david20120720/motoko_after_math_linefollower/doc/ossconf_2015_paper/paper.pdf

OSSConf 2014: 1–6

REQUIRED VALUE CLASSIFICATION USING KOHONEN NEURAL NETWORK

MICHAL CHOVANEC

Abstract. In this paper we describe situations classification using Kohonen neural network. Results are demonstrated on line following robot, where different curves are classified. Each classificated situation has corresponding required value output, which is used by low level control process. Network weights estimates are processed in real time.

Key words and phrases. kohonen neural network, learning controll, iterative learning, PID controll, mobile robot.

Klasifikácia žiadanej hodnoty Kohonenovou neurónovou sieťou

Abstrakt. V článku je popísaná klasifikácia situacií Kohonenovou neurónovou sieťou. Výsledky sú demonštrované na robotovi, sledujúom čiaru, kde sú klasifikované rôzne typy zákrut. Každá situácia má zodpovedajúci výstup, ktorý je vstupom do nižšej úrovne riadenia.

Keywords. kohonenová neurónová sieť, inteligentné učenie, iteraivne učenie, PID riadenie, mobilný robot.

Introduction

It is well known that, iterative learning control can handle any repetitive control process [1], [2]. Most of applications we can found in manipulators control in industry.
Some problems have iterative (or semiterative) character, but more than one output sequence is required. Consider problem of line following robot. To control robot speed, it is necessary to know curve shape. If we can compute associative memory, where input is line shape and output is required speed, we can handle this problem.

### 1. Problem formalisation

Consider two wheels (two motors) robot with differential drive [3]. For motors control signals we can write

r(n) = v(n) − d(n),

l(n) = v(n) + d(n),

(1)

2 | Konferencia OSSConf 2014

where
r(n) (l(n)) is right (left) motor control output, v(n) is common control input, d(n) is difference control input.
The value of d(n) can be computed with sufficient precision using PD controller [5]. Our goal is to properly estimate d(n) which is speed of robot. Robot motion equations can be written as
θ(n) = (1 + α)θ(n − 1) − αθ(n − 2) + b0(r(n) − l(n))
ν(n) = αν(n − 1) + (1 − α)b1(r(n) + l(n)) | (2)

where
θ is robot orientation (Yaw angle), ν is robot speed, α is robot inertia constant, within (0, 1), b0 and b1 are constants dependent on wheel distances, wheel diameters, gear ratio, and maximum speed.
If required θ and ν are known, we can successfully use pure PID control defining error as eθ(n) = θr(n) − θ(n), eν(n) = νr(n) − ν(n), where θr(n) and νr(n) are required values. In our line following problem, νr(n) is unknown, value θ(n) is readed from line position sensor. In fact, inertia of motors is much smaller than inertia of whole robot, for control θ(n) we can still use PD controller. Let the required value be θr(n) = 0, which means robot is straight on line.
Our goal is to properly estimate v(n) and control robot speed, to give enough time for PD control to setup θ(n). We are minimizing eθ(n) and maximizing ν(n) (corespoding to v(n)).

### 2. Controller design

On figure 1 we can sse block diagram of proposed controller.

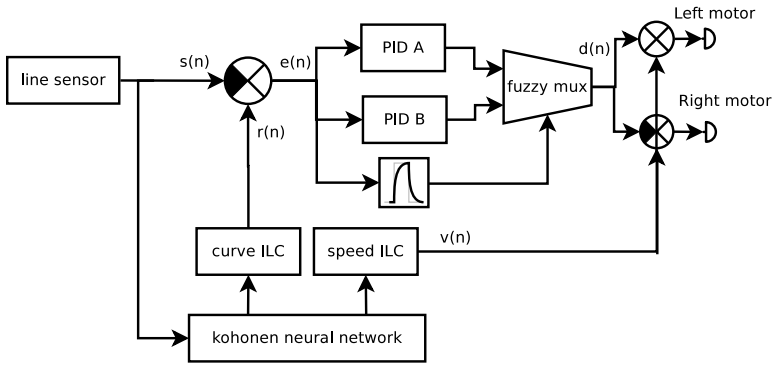
[picture p1: figure]

Figure 1. Robot controller.

Input is line position from sensor s(n). All values are normalised into h−1, 1i. Required value of θ(n) is marked as r(n). In simplificated case, it can be set to 0.

M. Chovanec: Required value classification using Kohonen neural network 3

Computed error is used as input into two PD controllers (PID in general, I-term is equal to zero, because 2 (θ part) has pole on 1 + 0i. If I-term is nonzero, there will be secondorder pole on 1 + 0i and system will be unstable).
PD controller outputs are mixed using fuzzy mux, which works as

d(n) = s

0
(n)a(n) + (1 − s

0
(n))b(n) | (3)

where
a(n) is PID A output, b(n) is PID B output, s

0
(n) is select input, from interval h0, 1i.

Select output is produced by nonlinear low pass filtered signal of e(n) as

s

0

(n) = (
s

0

(n − 1)k + (1 − k)|e(n)| for|e(n)| < s⁰ (n − 1),
|e(n)| | otherwise,

(4)

where k is filter constant, from (0, 1). This filter is smoothing error values. This system properly switches between two controllers, one for straight line and one for curved line.
To estimate v(n) we use Kohonen neural network [4] and iterative learning control. Neural network input is vector of s(n) values (implemented as FIFO, in experiments with size M = 16). Mark this vector as S(n) = [s(n), ..., s(n − M)]. Our goal, is to train network to make the classification of vectors S(n). Depending on count of classification classes, we choose corresponding neurons count
N. In experiments chooses we take N = 16 which means, 16 different curve shapes can be recognized.
Transfer function of j-th neuron can be written as

yj (n) =

M

X⁻¹

i=0

|s(n − i) − wj (i)| | (5)

where wj are neuron weights, initially chosen randomly and modified during learning process.
Neuron with smaller yq(n) will be marked as winning neuron, and weights modification will be done by formulae
wq(n) = ηwq(n − 1) + (1 − η)S(n), | (6)

where η is learning rate, from (0, 1) close to 1. Weights of neurons are slowly adapted to corresponding pattern. This can be illustrated on figure 2. Input was 2 dimensional, and goal is to find centers (green) of some data set (red). Input data set was produced by some Markov process. On figure 3 yq(n) values are shown.

4 | Konferencia OSSConf 2014

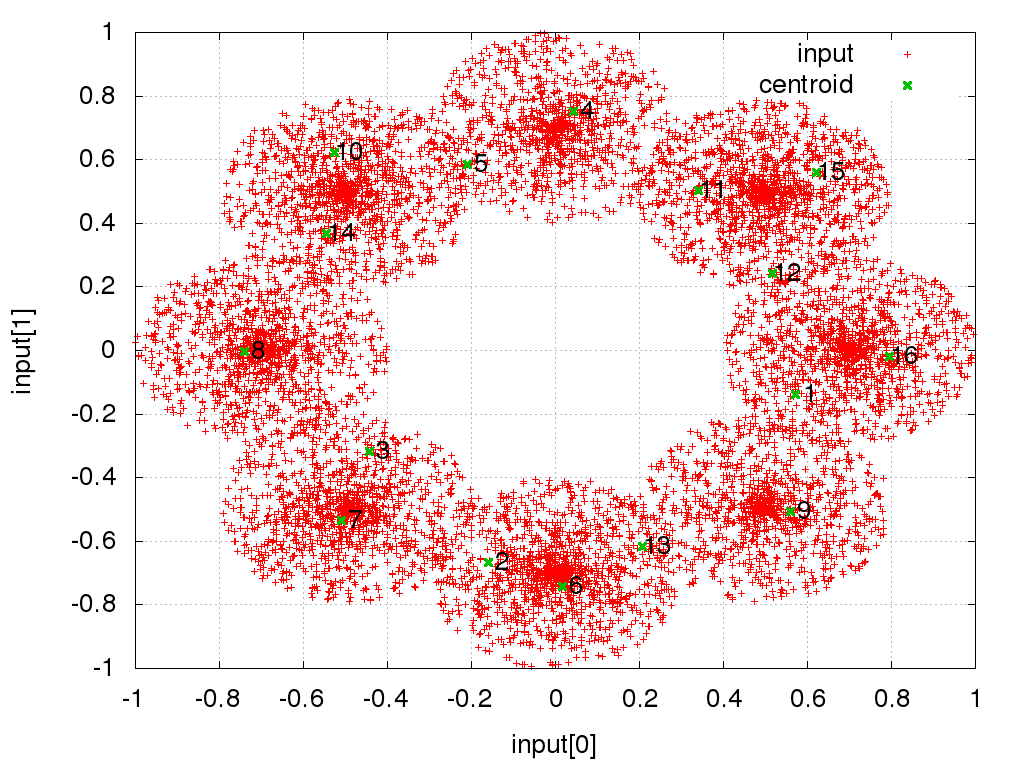
[picture p2: figure]

Figure 2. Kohonen test.

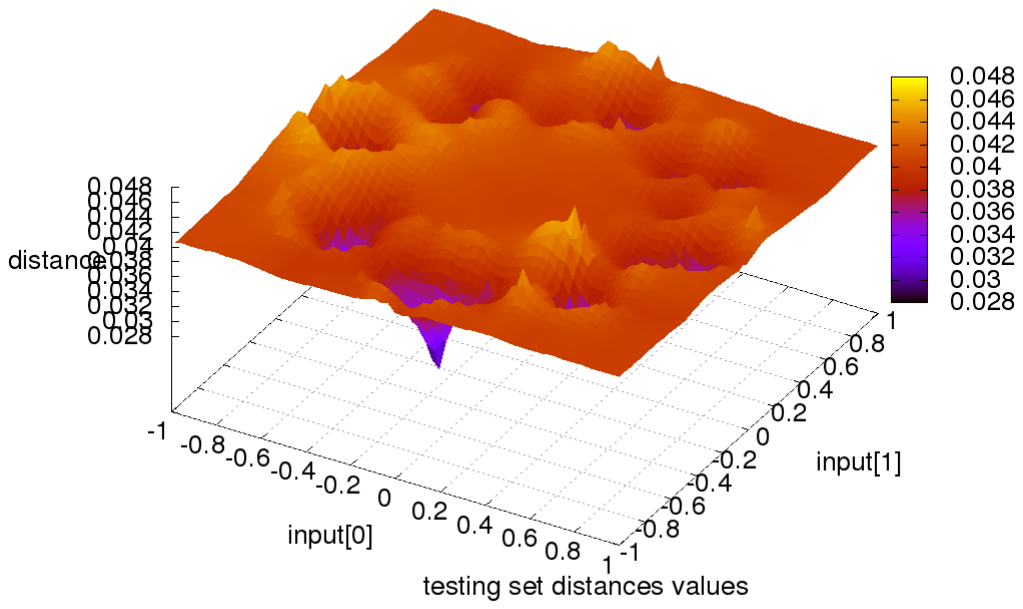
[picture p3: figure]

Figure 3. Kohonen test distances.

After found winning neuron, we need to find corresponding v(n), denote it by vq(n).

vq(n) = vq(n − 1) + 1 − k sf (n), | (7)

where sf (n) is low pass filtered s(n) value. That means robot speed v(n) on curve type q is rising if sf (n) is low.

M. Chovanec: Required value classification using Kohonen neural network 5

### 3. Experimental results

Robot was learning for few loops on short line race with different curve types. Resulting curve types are on figure 4. Each line represents one curve shape. To reduce space in memory, absolute value of s(n) as input into Kohonen neural network is used. We can seen many straight line positions, and few curves.

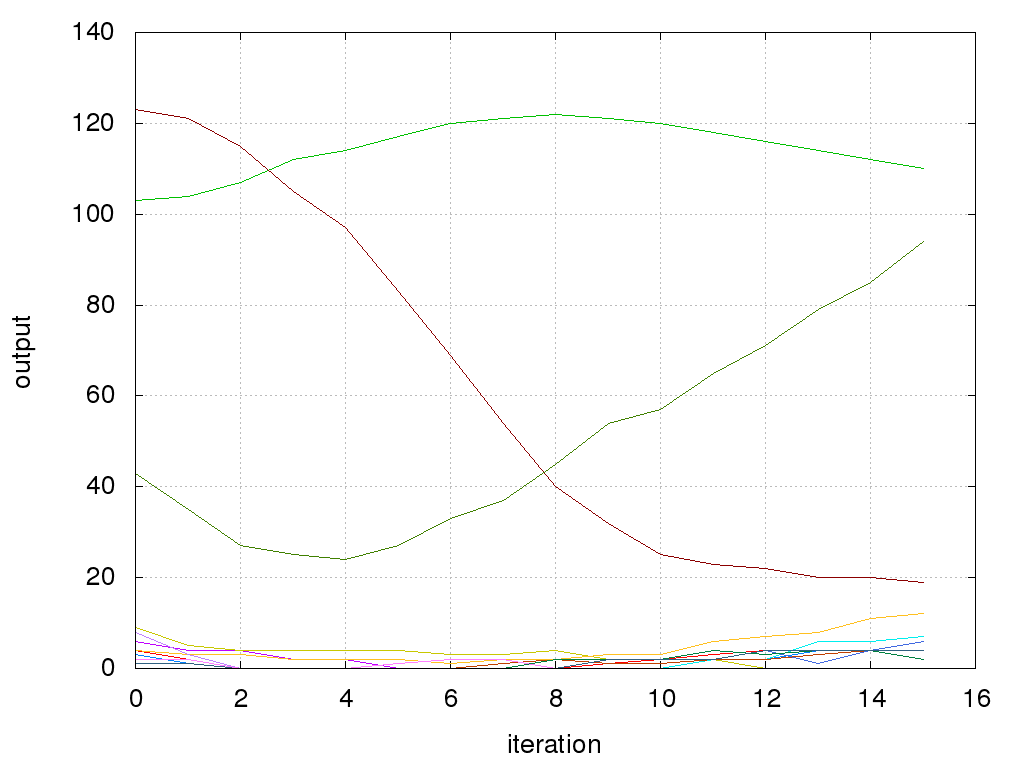
[picture p4: figure]

Figure 4. Resulting curves types.

### 4. Conclusions

In paper learning system for curve shape recognition using Kohonen neural network was described. Neural network results have corresponding speed output which control robot optional speed. Learning process is working in real time, on 75MHz ARM Cortex M4F microcontroller. Robot is on figure 5. Robot working video can be seen on [6]. More pictures are available on authors blog [7] and sources on github [8].

References

[1] Kevin L. Moore: Iterative learning control http://inside.mines.edu/~kmoore/survey. pdf. (http://inside.mines.edu/~kmoore/survey.pdf)
[2] Kevin L. Moore: An Introduction to Iterative Learning Control http://inside.mines.edu/~kmoore/ilc-intro-pdftex03-03.pdf. (http://inside.mines.edu/~kmoore/ilc-intro-pdftex03-03.pdf)
[3] Patrícia N. Guerra: Linear modelling and idendification of a mobile robot with differential drive http://www.dca.ufrn.br/~adelardo/artigos/ICINCO04b.pdf.
[4] R. Rojas: Neural Networks, Springer-Verlag, Berlin, 1996, Kohonen Neural Networks http: //page.mi.fu-berlin.de/rojas/neural/chapter/K15.pdf

6 | Konferencia OSSConf 2014

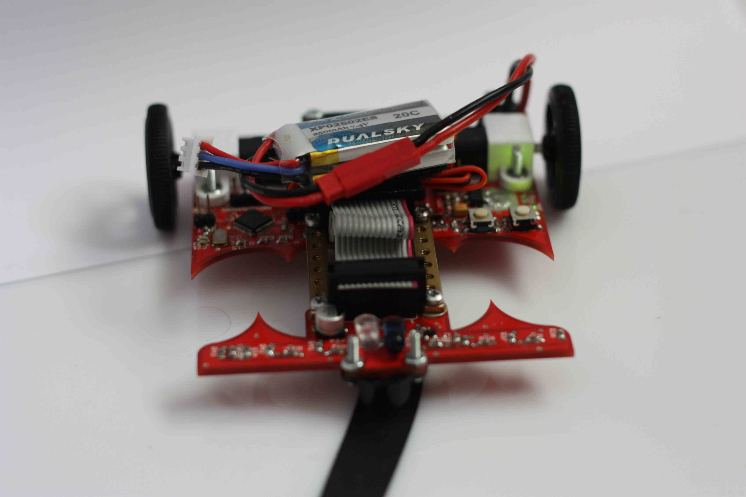
[picture p5: figure]

Figure 5. Testing robot.

[5] Michael Goldfarb, Taweedej Sirithanapipat: The effect of actuator saturation on the performance of PD-controlled servo systems http://research.vuse.vanderbilt.edu/cim/pubs/journal/35%20-%20Goldfarb%20and%20Sirithanapipat.pdf. (http://research.vuse.vanderbilt.edu/cim/pubs/journal/35%20-%20Goldfarb%20and%20Sirithanapipat.pdf)
[6] robot video link https://www.youtube.com/watch?v=SGaNlbkyQMg.
[7] authors blog http://aikenshin.blogspot.sk/.
[8] authors github https://github.com/michalnand/motoko_after_math_linefollower.

Contact address

Ing. Michal Chovanec, Department of Technical Cybernetics, Faculty of Management Science and Informatics, University of Žilina, Univerzitná 8215/1, 010 26 Žilina, Slovak Republic, E-mail address: michal.chovanec@yandex.com, http://aikenshin.blogspot.sk
