david20120720/motoko_after_math_linefollower/doc/ossconf_2015_presentation/presentation.pdf

# Klasifikácia žiadanej hodnoty Kohonenovou neurónovou sieťou

# Michal CHOVANEC Fakulta riadenia a informatiky

# Júl 2015

Michal CHOVANEC Fakulta riadenia a informatiky | Klasifikácia žiadanej hodnoty Kohonenovou neurónovou sieťou

# Cieľ

# Ako stanoviť žiadanú hodnotu pre robota sledujúceho čiaru?


# Cieľ

Riadia sa „rýchlosti” motorov r(n) a l(n).

# r(n) = v(n) − d(n)

# l(n) = v(n) + d(n)

(1)

# kde

v(n) je spoločná „rýchlosť” oboch motorov,
d(n) je rozdielová „rýchlosť” motorov.

# Viera : pre každú zákrutu existujú také v(n) a d(n), pre ktoré je

v(n) maximálne a poloha čiary s(n) ≈ 0.

# Štruktúra regulátora

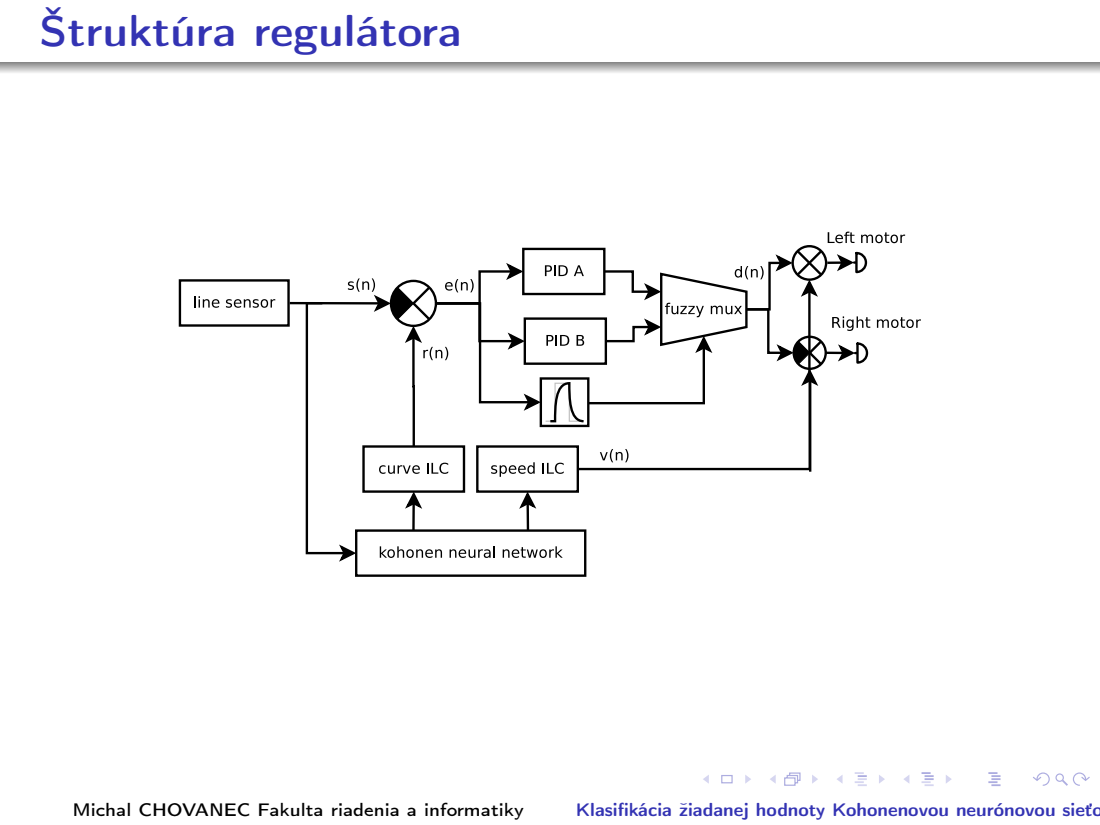
[picture p7: page 4]

# Kohonenova sieť

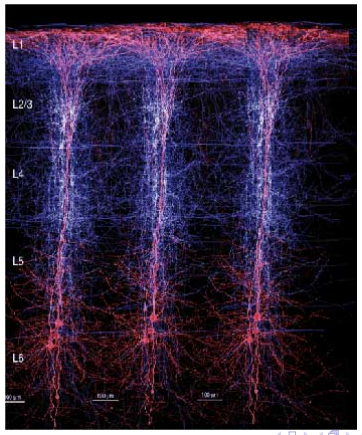
[picture p8: figure]

# Kohonenova sieť

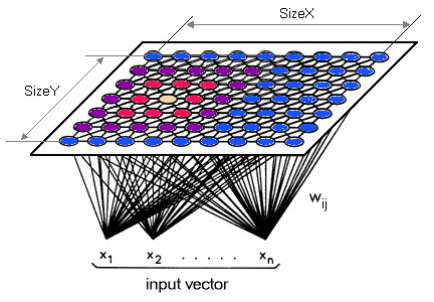
[picture p9: figure]

# Kohonenova sieť


# Kohonenova sieť - vo vnútri

# yj(n) = PM−1

i=0

|s(n − i) − wji(n)|, | (2)
wq(n) = ηwq(n − 1) + (1 − η)S(n) | (3)

# kde S(n) je predložený vzor (vektor so zložkami

S(n) = [s(n),s(n − 1), ...,s(n − i)]) ,
wj

je vektor váh, pre každý neurón,
wq je vektor váh výťazného neurónu, η je rýchlosť učenia, obvykle η ≈ 0.99.

# Výsledky klasifikácie zákrut


# Ďalšie smerovanie

# 1 Pripojenie kamery

# 2 Adaptívny regulátor

# 3 Iný pohľad na 1

# 4 ... veľa testovania

# Ďakujem za pozornosť

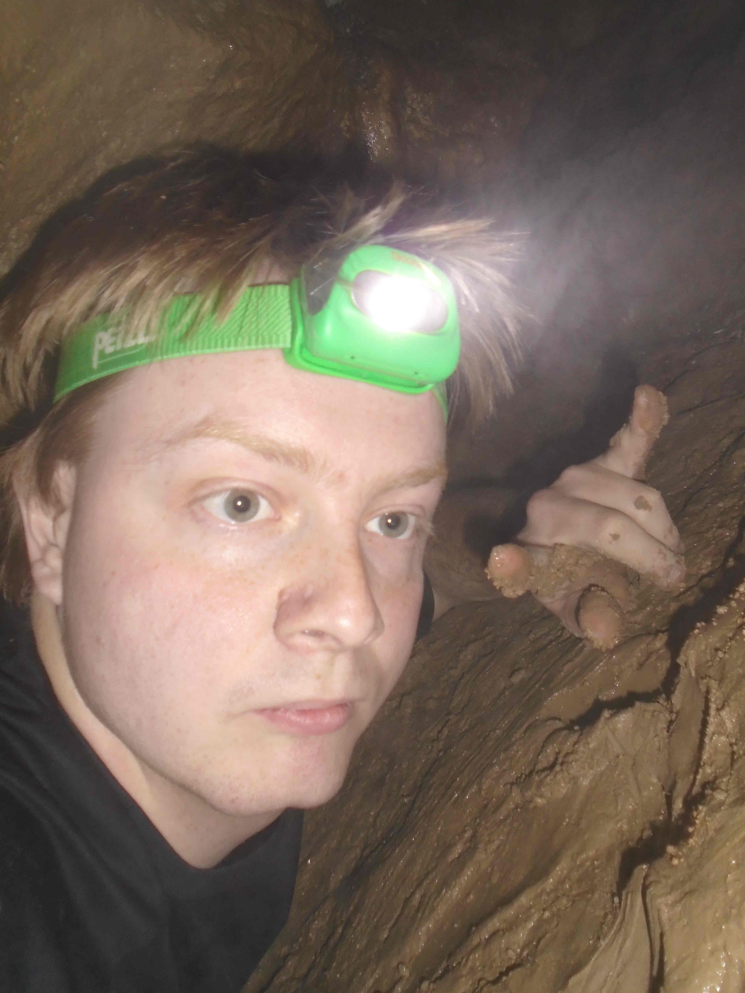
[picture p10: figure]

# michal.chovanec@yandex.ru
