david20120720/motoko_after_math_linefollower/doc/ossconf_2015_presentation/images/cortical_column.jpg

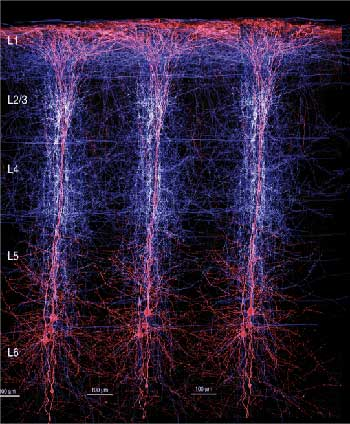
doc/ossconf_2015_presentation/images/cortical_column.jpg
