david20120720/motoko_after_math_linefollower/hardware/main_board_v3/png/board.png

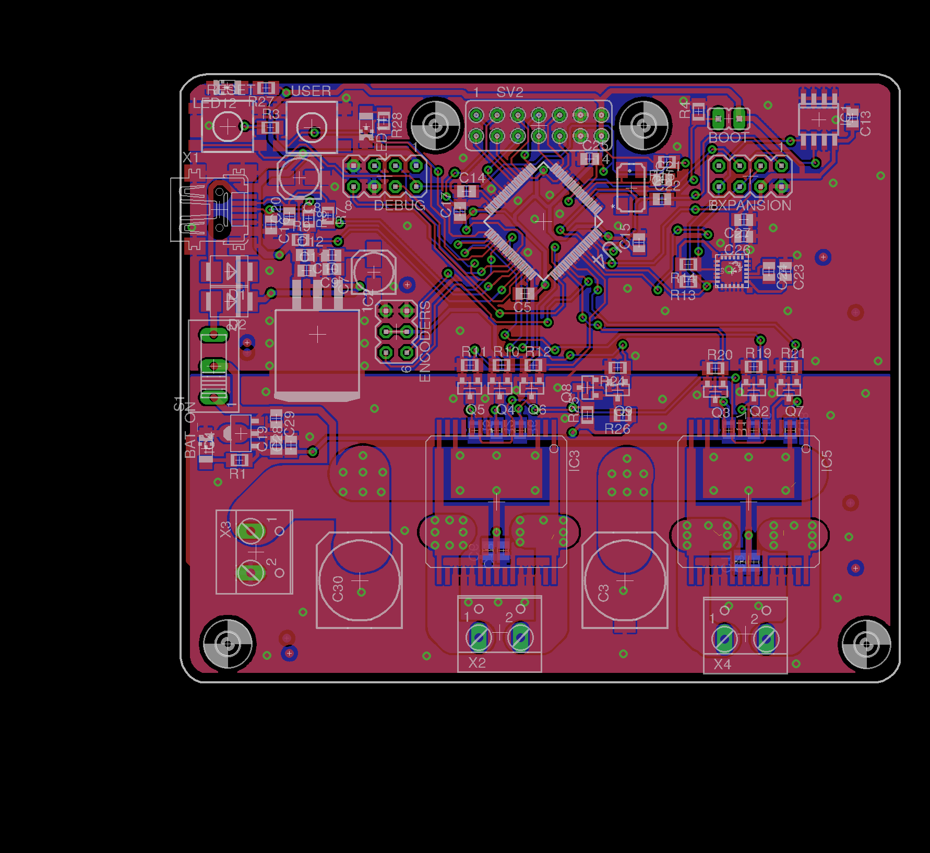
hardware/main_board_v3/png/board.png
