david20120720/motoko_after_math_linefollower/pictures/poster_02.png

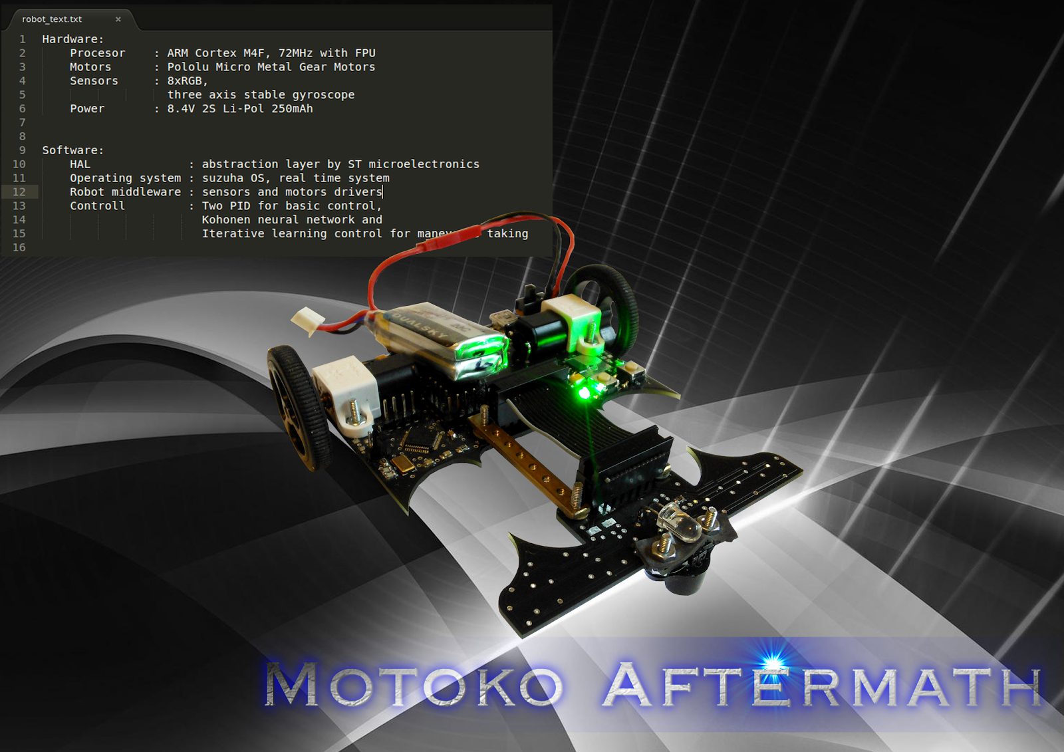
pictures/poster_02.png
