david20120720/motoko_after_math_linefollower/test/curve_predictor/predictor.png

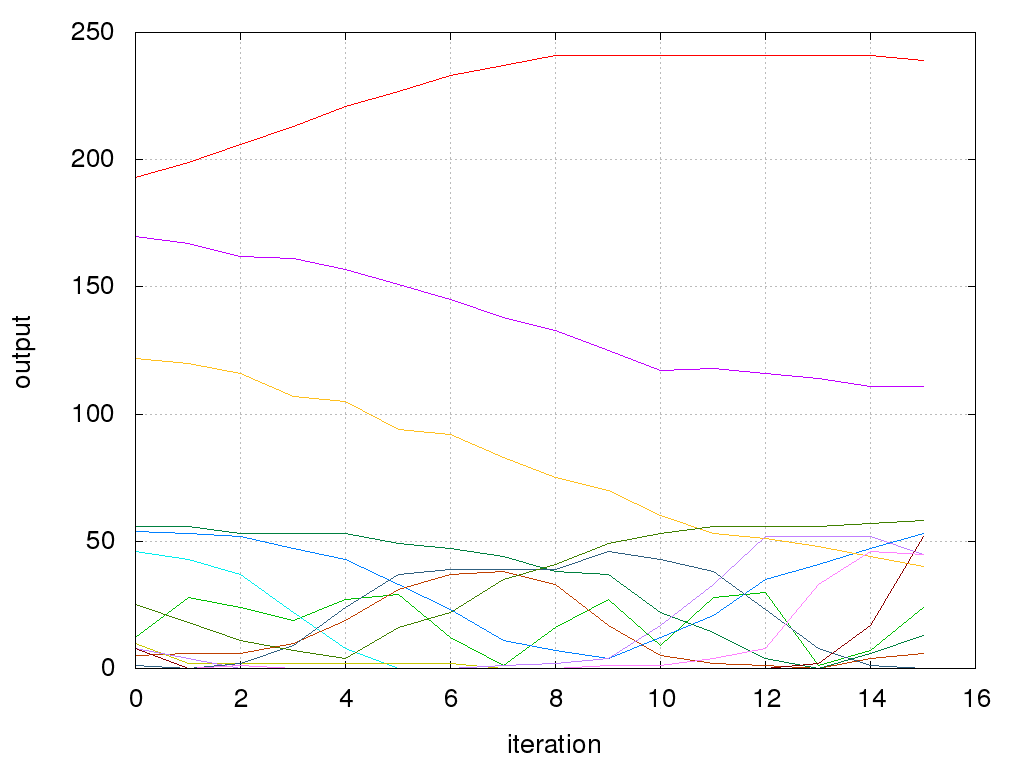
test/curve_predictor/predictor.png
