david20120720/motoko_after_math_linefollower/debug/bin/background.png

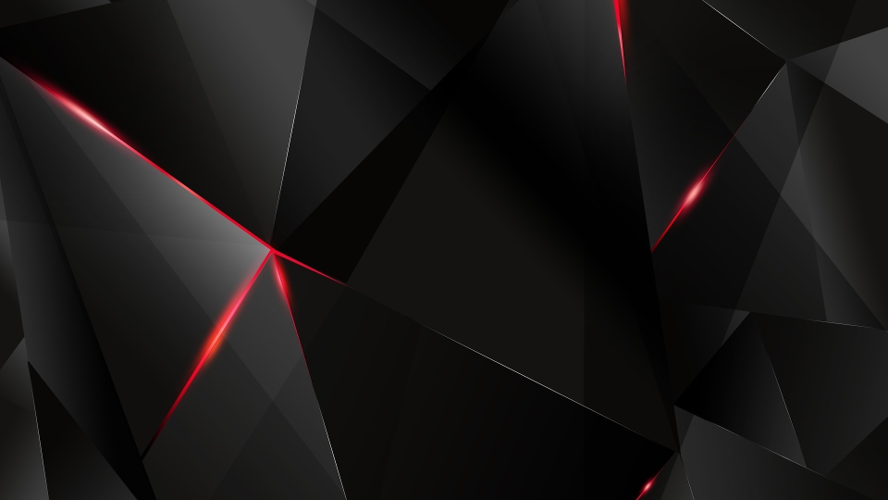
debug/bin/background.png
