david20120720/motoko_after_math_linefollower/hardware/rgb_comm/rgb_comm.brd

## EAGLE design hardware/rgb_comm/rgb_comm.brd (2016-12-18)

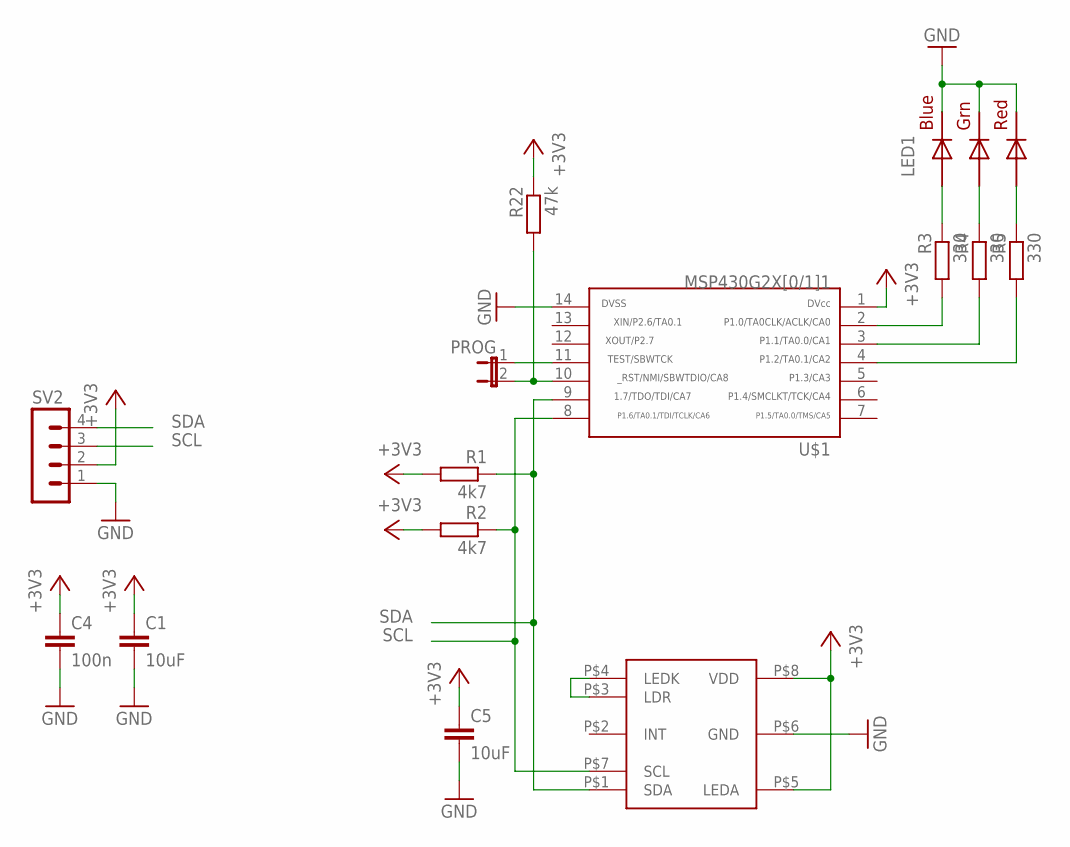
[picture p17: schematic rgb_comm.sch]

Parts:
C1, C5: 10uF; C0805
C4: 100n; C0805
LED1: ADAFRUIT_RGBLED5050
PROG: JP1E; JP1
R1, R2: 4k7; M0805
R3, R4, R5: 330; M0805
R22: 47k; M0805
SV2: MA04-1
U$1: G2X[0/1]1---PW14; PW14
U$2: APDS9950

Connections:
+3V3: C1.1, C4.1, C5.1, R1.2, R2.2, R22.1, SV2.2, U$1.1, U$2.P$5 (LEDA), U$2.P$8 (VDD)
GND: C1.2, C4.2, C5.2, LED1.4 (BLUE_C), LED1.5 (RED_C), LED1.6 (GREEN_C), SV2.1, U$1.14, U$2.P$6 (GND)
unnamed: PROG.1, U$1.11
unnamed: PROG.2, R22.2, U$1.10
unnamed: LED1.3 (BLUE_A), R3.1
unnamed: LED1.1 (GREEN_A), R4.1
unnamed: U$2.P$3 (LDR), U$2.P$4 (LEDK)
unnamed: LED1.2 (RED_A), R5.1
unnamed: R3.2, U$1.2
unnamed: R4.2, U$1.3
unnamed: R5.2, U$1.4
SCL: R2.1, SV2.3, U$1.8, U$2.P$7 (SCL)
SDA: R1.1, SV2.4, U$1.9, U$2.P$1 (SDA)

Board: 2 copper layers, 14 parts (4 on the bottom side), 13 nets, no tracks yet.
