david20120720/motoko_after_math_linefollower/hardware/main_board_v3/main.brd

## EAGLE design hardware/main_board_v3/main.brd (2016-12-18)

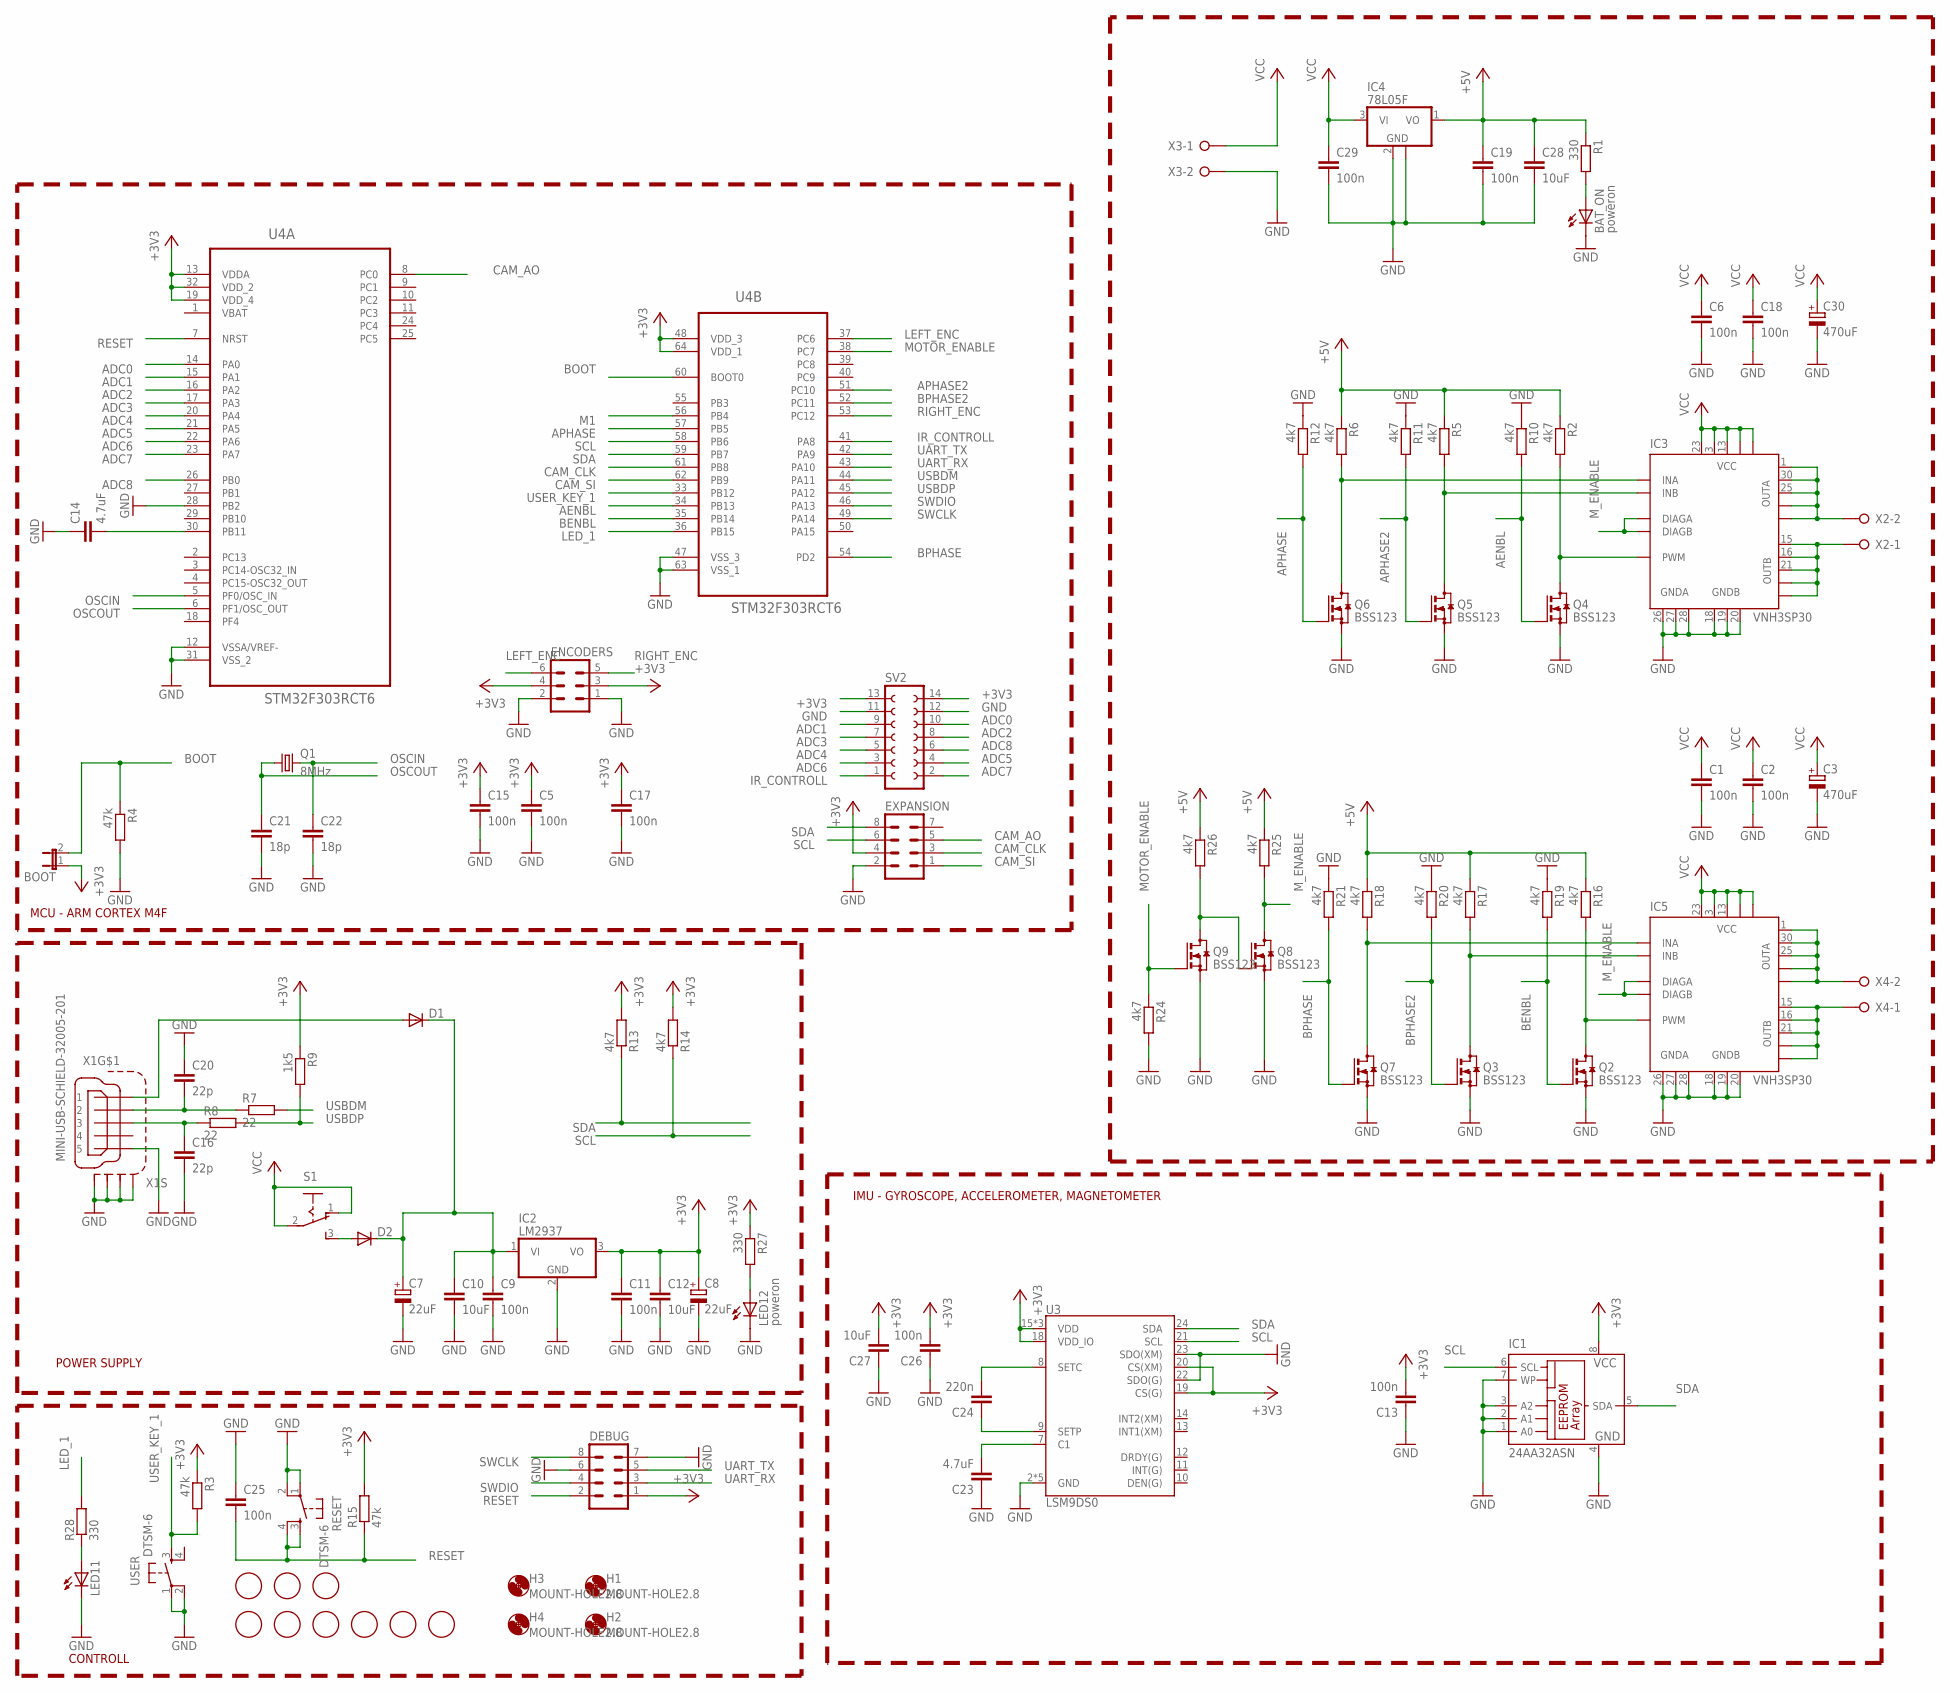
[picture p18: schematic main.sch]

Parts:
BAT_ON: poweron; CHIPLED_1206
BOOT: JP1E; JP1
C1, C2, C5, C6, C9, C11, C13, C15, C17, C18, C19, C25, C26, C29: 100n; C0805
C3, C30: 470uF; 140CLH-1014
C7, C8: 22uF; 153CLV-0505
C10, C12, C27, C28: 10uF; C0805
C14, C23: 4.7uF; C0805
C16, C20: 22p; C0805
C21, C22: 18p; C0805
C24: 220n; C0805
D1, D2: DIODE-SMB; SMB
DEBUG: MA04-2
ENCODERS: MA03-2
EXPANSION: MA04-2
H1, H2, H3, H4: MOUNT-HOLE2.8; 2,8
IC1: 24AA32ASN; SO-08
IC2: LM2937; TO263-3
IC3, IC5: VNH3SP30; MULTIPOWERSO-30
IC4: 78L05F; SOT89
LED11: LEDCHIPLED_1206; CHIPLED_1206
LED12: poweron; CHIPLED_1206
Q1: 8MHz; CTS406
Q2, Q3, Q4, Q5, Q6, Q7, Q8, Q9: BSS123; SOT23
R1, R27, R28: 330; M0805
R2, R5, R6, R10, R11, R12, R13, R14, R16, R17, R18, R19, R20, R21, R24, R25, R26: 4k7; M0805
R3, R4, R15: 47k; M0805
R7, R8: 22; M0805
R9: 1k5; M0805
RESET: DTSM-6
S1: 255SB
SV2: FE07-2
U3: LSM9DS0; LGA-24
U4: STM32F303RCT6; QFP50P1200X1200X160-64N
U$1, U$2, U$3, U$4, U$5, U$6, U$7, U$8, U$9: FIDUCIAL; FIDUCIAL_1MM
USER: DTSM-6
X1: MINI-USB-SCHIELD-32005-201; 32005-201
X2, X3, X4: W237-02P; W237-132

Connections:
+3V3: BOOT.1, C5.1, C8.+, C11.1, C12.1, C13.2, C15.1, C17.1, C26.2, C27.2, DEBUG.1, ENCODERS.3, ENCODERS.4, EXPANSION.4, IC1.8 (VCC), IC2.3 (VO), R3.1, R9.1, R13.2, R14.2, R15.2, R27.1, SV2.13, SV2.14, U3.15 (VDD), U3.16 (VDD), U3.17 (VDD), U3.18 (VDD_IO), U3.19 (CS(G)), U3.20 (CS(XM)), U4.13 (VDDA), U4.19 (VDD_4), U4.32 (VDD_2), U4.48 (VDD_3), U4.64 (VDD_1)
+5V: C19.1, C28.1, IC4.1 (VO), R1.1, R2.1, R5.1, R6.1, R16.1, R17.1, R18.1, R25.1, R26.1
ADC0: SV2.10, U4.14 (PA0)
ADC1: SV2.9, U4.15 (PA1)
ADC2: SV2.8, U4.16 (PA2)
ADC3: SV2.7, U4.17 (PA3)
ADC4: SV2.5, U4.20 (PA4)
ADC5: SV2.4, U4.21 (PA5)
ADC6: SV2.3, U4.22 (PA6)
ADC7: SV2.2, U4.23 (PA7)
ADC8: SV2.6, U4.26 (PB0)
AENBL: Q4.1 (G), R10.2, U4.34 (PB13)
APHASE: Q6.1 (G), R12.2, U4.57 (PB5)
APHASE2: Q5.1 (G), R11.2, U4.51 (PC10)
BENBL: Q2.1 (G), R19.2, U4.35 (PB14)
BOOT: BOOT.2, R4.1, U4.60 (BOOT0)
BPHASE: Q7.1 (G), R21.2, U4.54 (PD2)
BPHASE2: Q3.1 (G), R20.2, U4.52 (PC11)
CAM_AO: EXPANSION.5, U4.8 (PC0)
CAM_CLK: EXPANSION.3, U4.61 (PB8)
CAM_SI: EXPANSION.1, U4.62 (PB9)
GND: BAT_ON.C, C1.2, C2.2, C3.-, C5.2, C6.2, C7.-, C8.-, C9.2, C10.2, C11.2, C12.2, C13.1, C14.1, C15.2, C16.2, C17.2, C18.2, C19.2, C20.1, C21.2, C22.2, C23.1, C25.1, C26.1, C27.1, C28.2, C29.2, C30.-, DEBUG.6, DEBUG.7, ENCODERS.1, ENCODERS.2, EXPANSION.2, IC1.1 (A0), IC1.2 (A1), IC1.3 (A2), IC1.4 (GND), IC1.7 (WP), IC2.2 (GND), IC3.18 (GNDB), IC3.19 (GNDB), IC3.20 (GNDB), IC3.26 (GNDA), IC3.27 (GNDA), IC3.28 (GNDA), IC4.2 (GND), IC4.2@1 (GND), IC5.18 (GNDB), IC5.19 (GNDB), IC5.20 (GNDB), IC5.26 (GNDA), IC5.27 (GNDA), IC5.28 (GNDA), LED11.C, LED12.C, Q2.2 (S), Q3.2 (S), Q4.2 (S), Q5.2 (S), Q6.2 (S), Q7.2 (S), Q8.2 (S), Q9.2 (S), R4.2, R10.1, R11.1, R12.1, R19.1, R20.1, R21.1, R24.2, RESET.1, RESET.2, SV2.11, SV2.12, U3.2 (GND), U3.3 (GND), U3.4 (GND), U3.5 (GND), U3.6 (GND), U3.22 (SDO(G)), U3.23 (SDO(XM)), U4.12 (VSSA/VREF-), U4.28 (PB2), U4.31 (VSS_2), U4.47 (VSS_3), U4.63 (VSS_1), USER.1, USER.2, X1.5, X1.M1 (S1), X1.M2 (S2), X1.M3 (S3), X1.M4 (S4), X3.2
IR_CONTROLL: SV2.1, U4.41 (PA8)
LED_1: R28.2, U4.36 (PB15)
LEFT_ENC: ENCODERS.6, U4.37 (PC6)
M1: U4.56 (PB4)
MOTOR_ENABLE: Q9.1 (G), R24.1, U4.38 (PC7)
M_ENABLE: IC3.6 (DIAGA), IC3.10 (DIAGB), IC5.6 (DIAGA), IC5.10 (DIAGB), Q8.3 (D), R25.2
unnamed: D2.A, S1.3 (S)
unnamed: C7.+, C9.1, C10.1, D1.C, D2.C, IC2.1 (VI)
unnamed: BAT_ON.A, R1.2
unnamed: IC5.5 (INA), Q7.3 (D), R18.2
unnamed: IC5.11 (INB), Q3.3 (D), R17.2
unnamed: C23.2, U3.7 (C1)
unnamed: C24.2, U3.8 (SETC)
unnamed: IC5.8 (PWM), Q2.3 (D), R16.2
unnamed: IC5.1 (OUTA), IC5.25 (OUTA), IC5.30 (OUTA), IC5.OUTA, IC5.OUTA@1 (OUTA), X4.2
unnamed: C24.1, U3.9 (SETP)
unnamed: IC5.15 (OUTB), IC5.16 (OUTB), IC5.21 (OUTB), IC5.OUTB, IC5.OUTB@1 (OUTB), X4.1
unnamed: C14.2, U4.30 (PB11)
unnamed: Q8.1 (G), Q9.3 (D), R26.2
unnamed: IC3.5 (INA), Q6.3 (D), R6.2
unnamed: IC3.11 (INB), Q5.3 (D), R5.2
unnamed: IC3.8 (PWM), Q4.3 (D), R2.2
unnamed: IC3.1 (OUTA), IC3.25 (OUTA), IC3.30 (OUTA), IC3.OUTA, IC3.OUTA@1 (OUTA), X2.2
unnamed: LED12.A, R27.2
unnamed: IC3.15 (OUTB), IC3.16 (OUTB), IC3.21 (OUTB), IC3.OUTB, IC3.OUTB@1 (OUTB), X2.1
unnamed: LED11.A, R28.1
unnamed: C20.2, R7.1, X1.2
unnamed: C16.1, R8.1, X1.3
unnamed: D1.A, X1.1
OSCIN: C22.1, Q1.3 (2), U4.5 (PF0/OSC_IN)
OSCOUT: C21.1, Q1.1, U4.6 (PF1/OSC_OUT)
RESET: C25.2, DEBUG.2, R15.1, RESET.3, RESET.4, U4.7 (NRST)
RIGHT_ENC: ENCODERS.5, U4.53 (PC12)
SCL: EXPANSION.6, IC1.6 (SCL), R14.1, U3.21 (SCL), U4.58 (PB6)
SDA: EXPANSION.8, IC1.5 (SDA), R13.1, U3.24 (SDA), U4.59 (PB7)
SWCLK: DEBUG.8, U4.49 (PA14)
SWDIO: DEBUG.4, U4.46 (PA13)
UART_RX: DEBUG.3, U4.43 (PA10)
UART_TX: DEBUG.5, U4.42 (PA9)
USBDM: R7.2, U4.44 (PA11)
USBDP: R8.2, R9.2, U4.45 (PA12)
USER_KEY_1: R3.2, U4.33 (PB12), USER.3
VBAT: U4.1 (VBAT)
VCC: C1.1, C2.1, C3.+, C6.1, C18.1, C29.1, C30.+, IC3.3 (VCC), IC3.13 (VCC), IC3.23 (VCC), IC3.VCC, IC3.VCC@1 (VCC), IC4.3 (VI), IC5.3 (VCC), IC5.13 (VCC), IC5.23 (VCC), IC5.VCC, IC5.VCC@1 (VCC), S1.1 (O), S1.2, X3.1

Notes on the sheet:
POWER SUPPLY
CONTROLL
MCU - ARM CORTEX M4F
IMU - GYROSCOPE, ACCELEROMETER, MAGNETOMETER

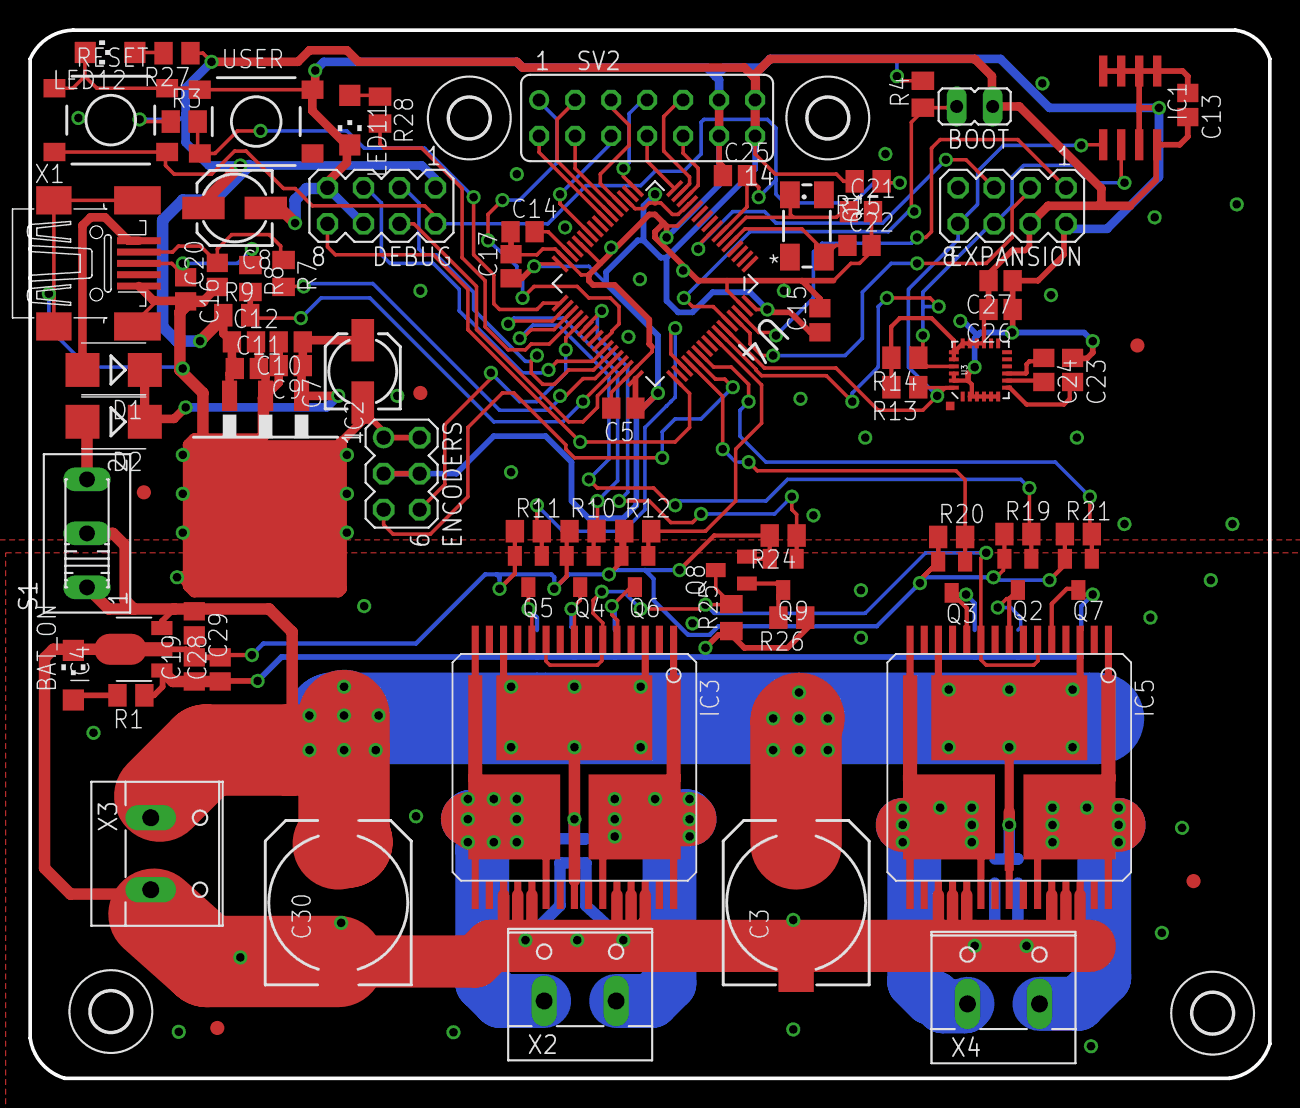
[picture p19: board hardware/main_board_v3/main.brd from above]

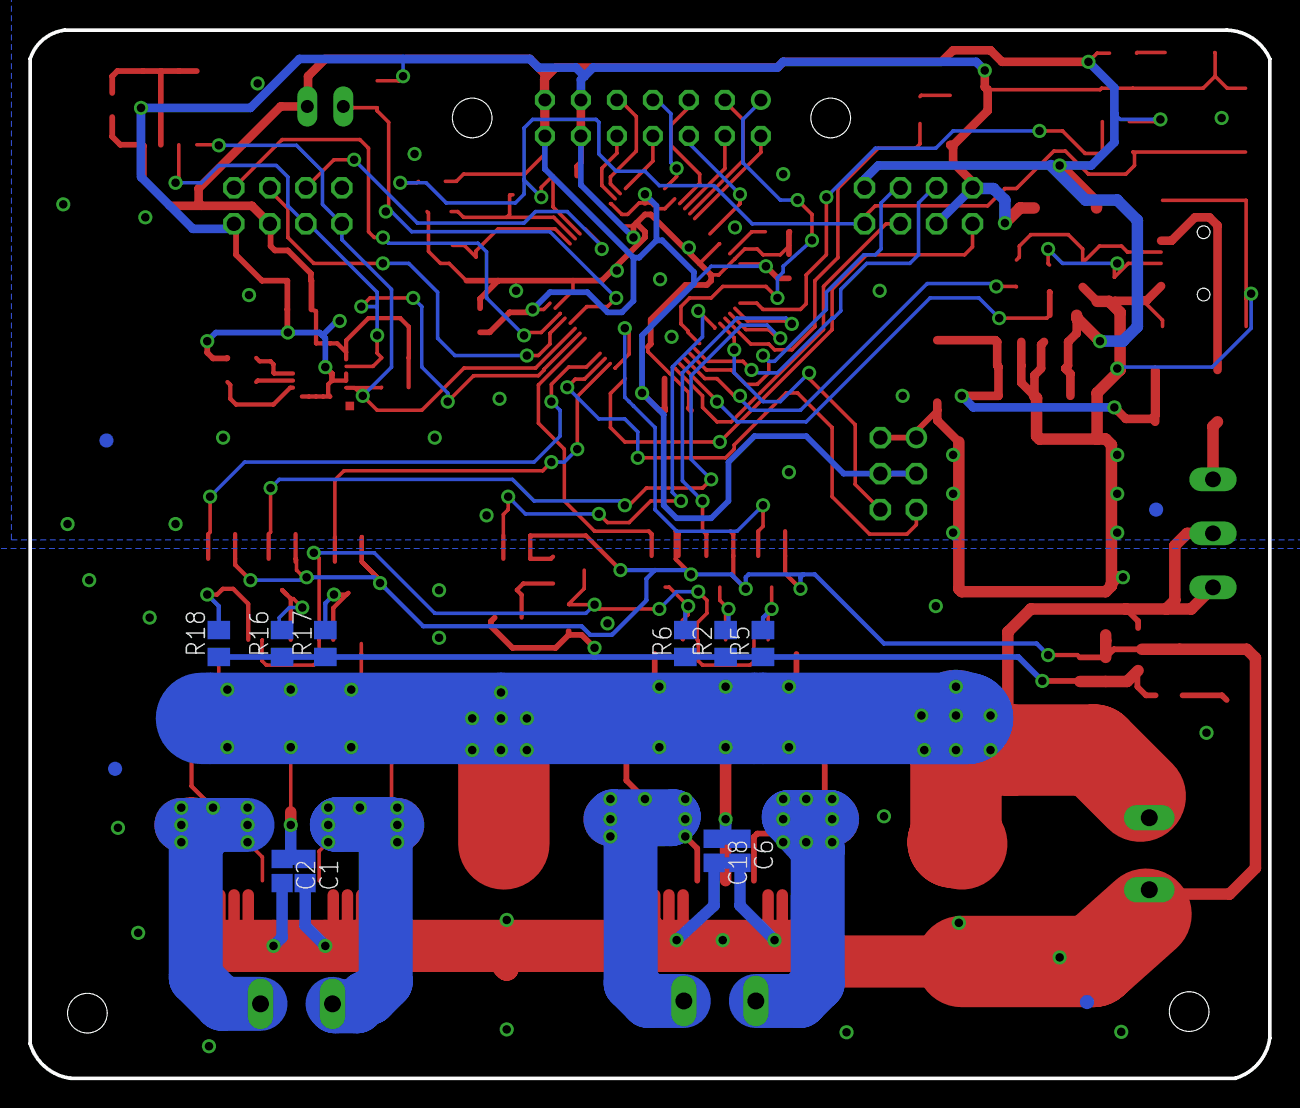
[picture p20: board hardware/main_board_v3/main.brd from below]

Board: 2 copper layers, 87.5 x 74.0 mm, 101 parts (14 on the bottom side), 64 nets.
