david20120720/motoko_after_math_linefollower/hardware/magnetic_encoder/encoder.brd

## EAGLE design hardware/magnetic_encoder/encoder.brd (2016-12-18)

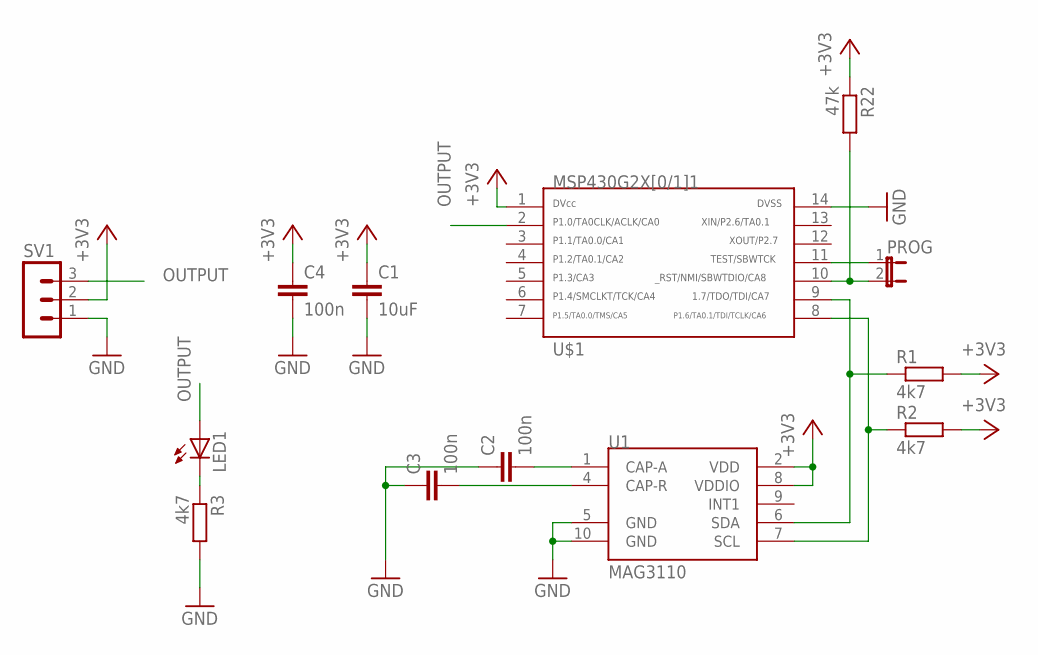
[picture p21: schematic encoder.sch]

Parts:
C1: 10uF; C0805
C2, C3, C4: 100n; C0805
LED1: LEDSML1206; SML1206
PROG: JP1E; JP1
R1, R2, R3: 4k7; M0805
R22: 47k; M0805
SV1: MA03-1
U1: MAG3110; DFN-10
U$1: G2X[0/1]1---PW14; PW14

Connections:
+3V3: C1.1, C4.1, R1.2, R2.2, R22.1, SV1.2, U1.2 (VDD), U1.8 (VDDIO), U$1.1
GND: C1.2, C2.1, C3.1, C4.2, R3.2, SV1.1, U1.5 (GND), U1.10 (GND), U$1.14
unnamed: PROG.1, U$1.11
unnamed: PROG.2, R22.2, U$1.10
unnamed: R1.1, U1.6 (SDA), U$1.9
unnamed: R2.1, U1.7 (SCL), U$1.8
unnamed: C3.2, U1.4 (CAP-R)
unnamed: C2.2, U1.1 (CAP-A)
unnamed: LED1.C, R3.1
OUTPUT: LED1.A, SV1.3, U$1.2

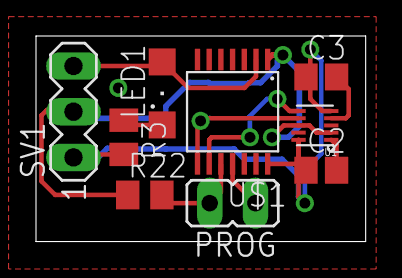
[picture p22: board encoder.brd from above]

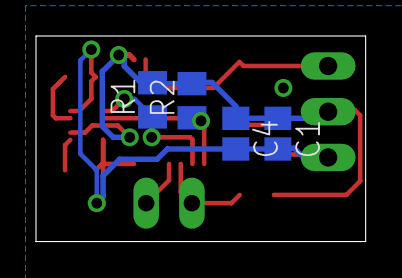
[picture p23: board encoder.brd from below]

Board: 2 copper layers, 18.3 x 11.4 mm, 13 parts (4 on the bottom side), 10 nets.
