david20120720/motoko_after_math_linefollower/hardware/rgb_board/sensor.brd

## EAGLE design hardware/rgb_board/sensor.brd (2015-12-19)

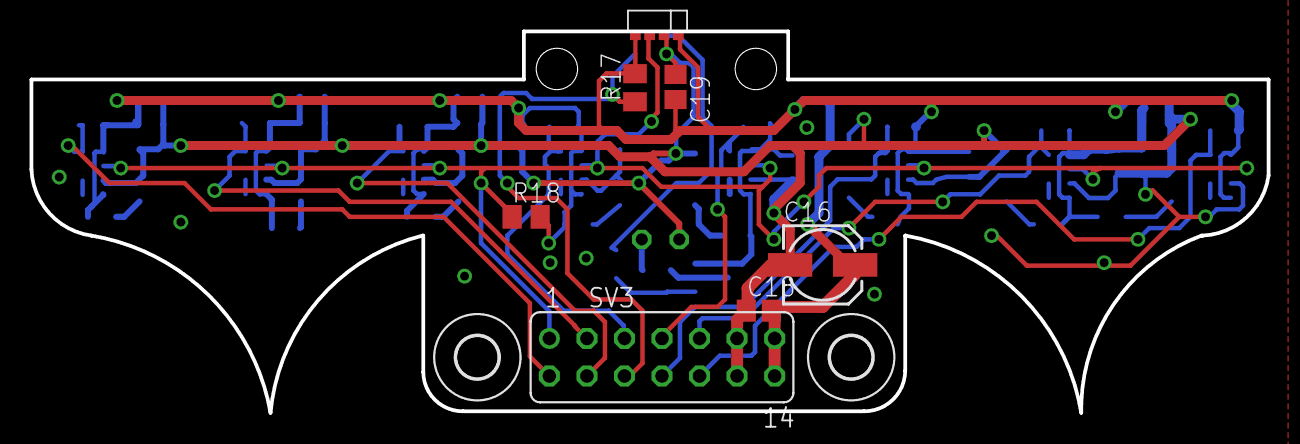
[picture p24: board sensor.brd from above]

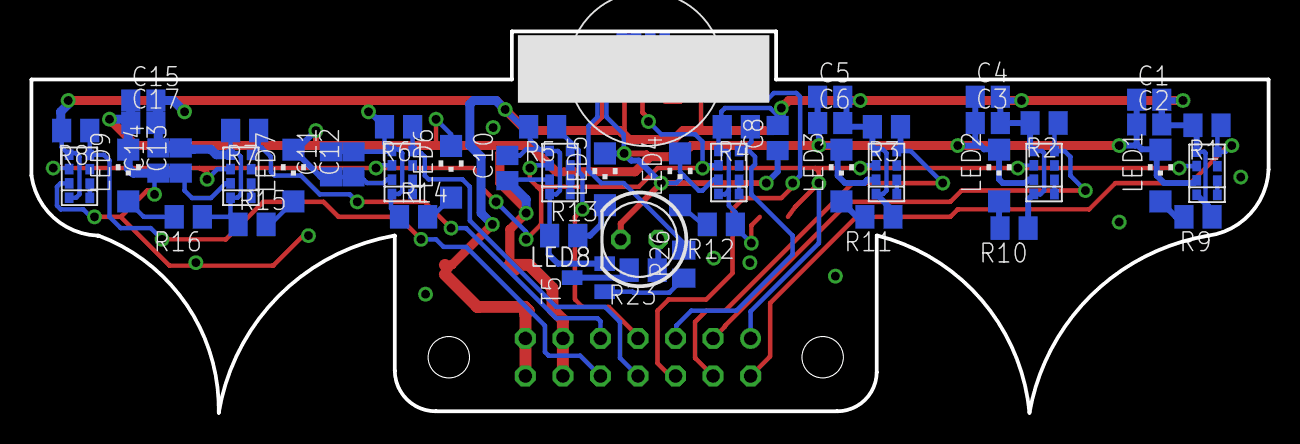
[picture p25: board sensor.brd from below]

Board: 2 copper layers, 83.7 x 25.8 mm, 60 parts (51 on the bottom side), 32 nets.

Parts:
C1, C3, C5, C11, C13, C15, C18: 10uF; C0805
C2, C4, C6, C8, C10, C12, C14, C17, C19: 100n; C0805
C16: 22uF; 153CLV-0505
H3, H4: MOUNT-HOLE2.8; 2,8
LED1, LED2, LED3, LED4, LED5, LED6, LED7, LED9: CHIPLED_1206
LED8: LED5MM
R1, R2, R3, R4, R5, R6, R7, R8, R17, R18: 4k7; M0805
R9, R10, R11, R12, R13, R14, R15, R16, R26: 330; M0805
R23: 22; M0805
SV3: FE07-2
T5: SOT23-BEC
U$1, U$4, U$5, U$6, U$7, U$8, U$9, U$10: APDS9950
U$2: APDS9950_EDGE
U$3: BALL_3/8

Connections:
+3V3: C1.2, C2.2, C3.2, C4.2, C5.2, C6.2, C8.2, C10.2, C11.2, C12.2, C13.2, C14.2, C15.2, C16.+, C17.2, C18.2, C19.2, R1.2, R2.2, R3.2, R4.2, R5.2, R6.2, R7.2, R8.2, R9.1, R10.1, R11.1, R12.1, R13.1, R14.1, R15.1, R16.1, R17.2, R18.2, SV3.13, SV3.14, T5.E, U$1.P$5, U$1.P$8, U$2.P$5, U$2.P$8, U$4.P$5, U$4.P$8, U$5.P$5, U$5.P$8, U$6.P$5, U$6.P$8, U$7.P$5, U$7.P$8, U$8.P$5, U$8.P$8, U$9.P$5, U$9.P$8, U$10.P$5, U$10.P$8
ADC0_: R8.1, SV3.10, U$10.P$1
ADC1_: R7.1, SV3.9, U$9.P$1
ADC2_: R6.1, SV3.8, U$8.P$1
ADC3_: R5.1, SV3.7, U$7.P$1
ADC4_: R4.1, SV3.5, U$6.P$1
ADC5_: R3.1, SV3.4, U$5.P$1
ADC6_: R2.1, SV3.3, U$4.P$1
ADC7_: R1.1, SV3.2, U$1.P$1
ADC8_: R17.1, SV3.6, U$2.P$1
GND: C1.1, C2.1, C3.1, C4.1, C5.1, C6.1, C8.1, C10.1, C11.1, C12.1, C13.1, C14.1, C15.1, C16.-, C17.1, C18.1, C19.1, LED1.C, LED2.C, LED3.C, LED4.C, LED5.C, LED6.C, LED7.C, LED8.K, LED9.C, SV3.11, SV3.12, U$1.P$6, U$2.P$6, U$4.P$6, U$5.P$6, U$6.P$6, U$7.P$6, U$8.P$6, U$9.P$6, U$10.P$6
unnamed: R23.2, T5.C
unnamed: U$4.P$3, U$4.P$4
unnamed: LED1.A, R9.2
unnamed: U$1.P$3, U$1.P$4
unnamed: LED2.A, R10.2
unnamed: LED3.A, R11.2
unnamed: LED4.A, R12.2
unnamed: LED5.A, R13.2
unnamed: U$5.P$3, U$5.P$4
unnamed: LED6.A, R14.2
unnamed: LED7.A, R15.2
unnamed: U$6.P$3, U$6.P$4
unnamed: LED9.A, R16.2
unnamed: R26.2, U$2.P$3, U$2.P$4
unnamed: U$7.P$3, U$7.P$4
unnamed: U$8.P$3, U$8.P$4
unnamed: U$9.P$3, U$9.P$4
unnamed: LED8.A, R23.1
unnamed: U$10.P$3, U$10.P$4
unnamed: R26.1, T5.B
SCL: R18.1, SV3.1, U$1.P$7, U$2.P$7, U$4.P$7, U$5.P$7, U$6.P$7, U$7.P$7, U$8.P$7, U$9.P$7, U$10.P$7
