david20120720/motoko_after_math_linefollower/hardware/main_board/main.brd

## EAGLE design hardware/main_board/main.brd (2015-12-19, an earlier design)

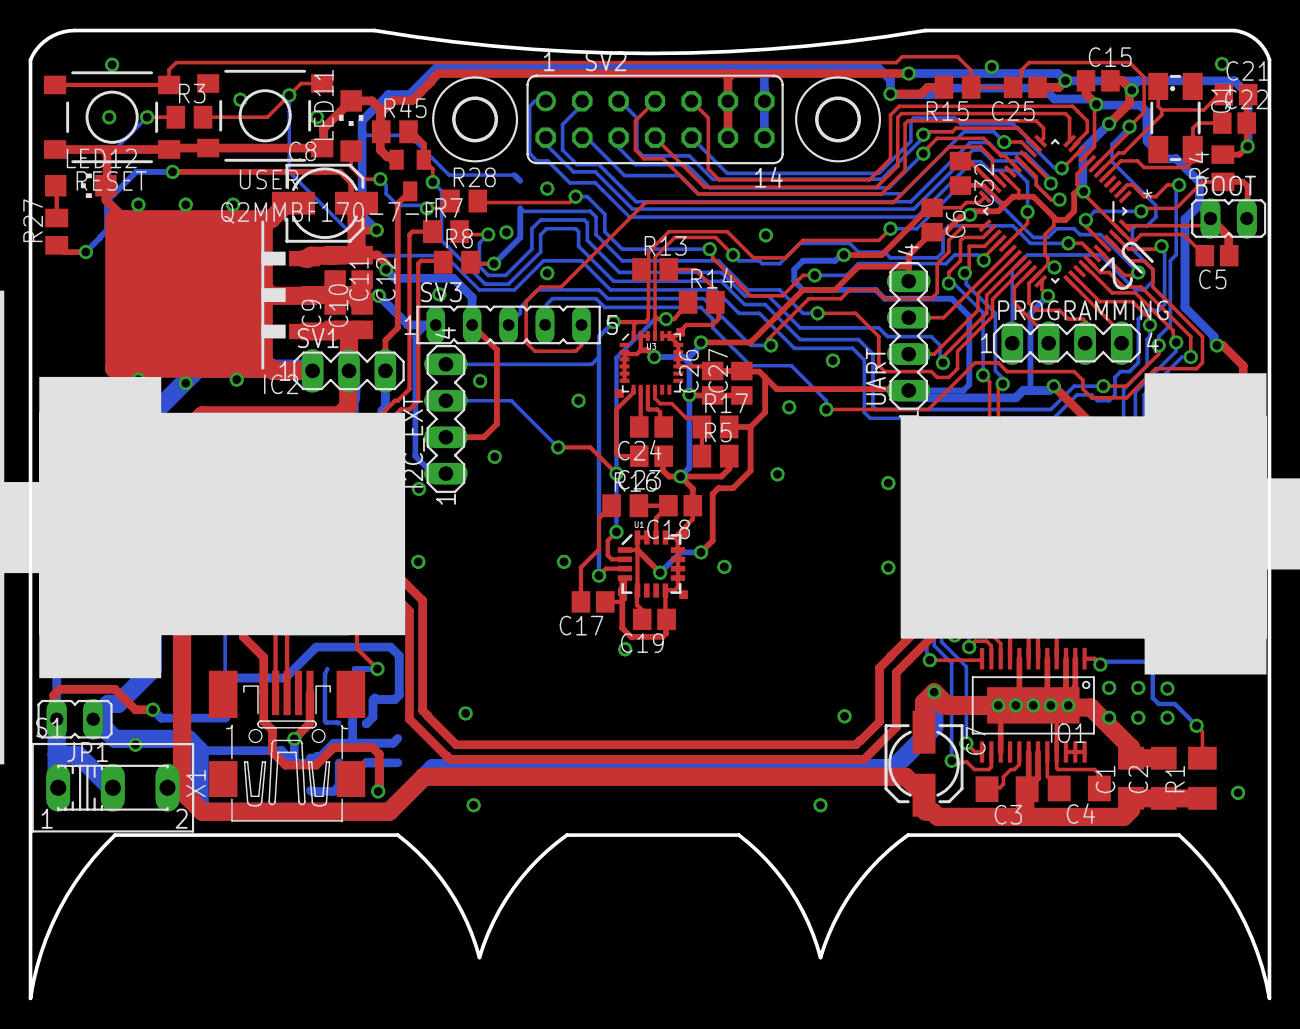
[picture p26: board hardware/main_board/main.brd from above]

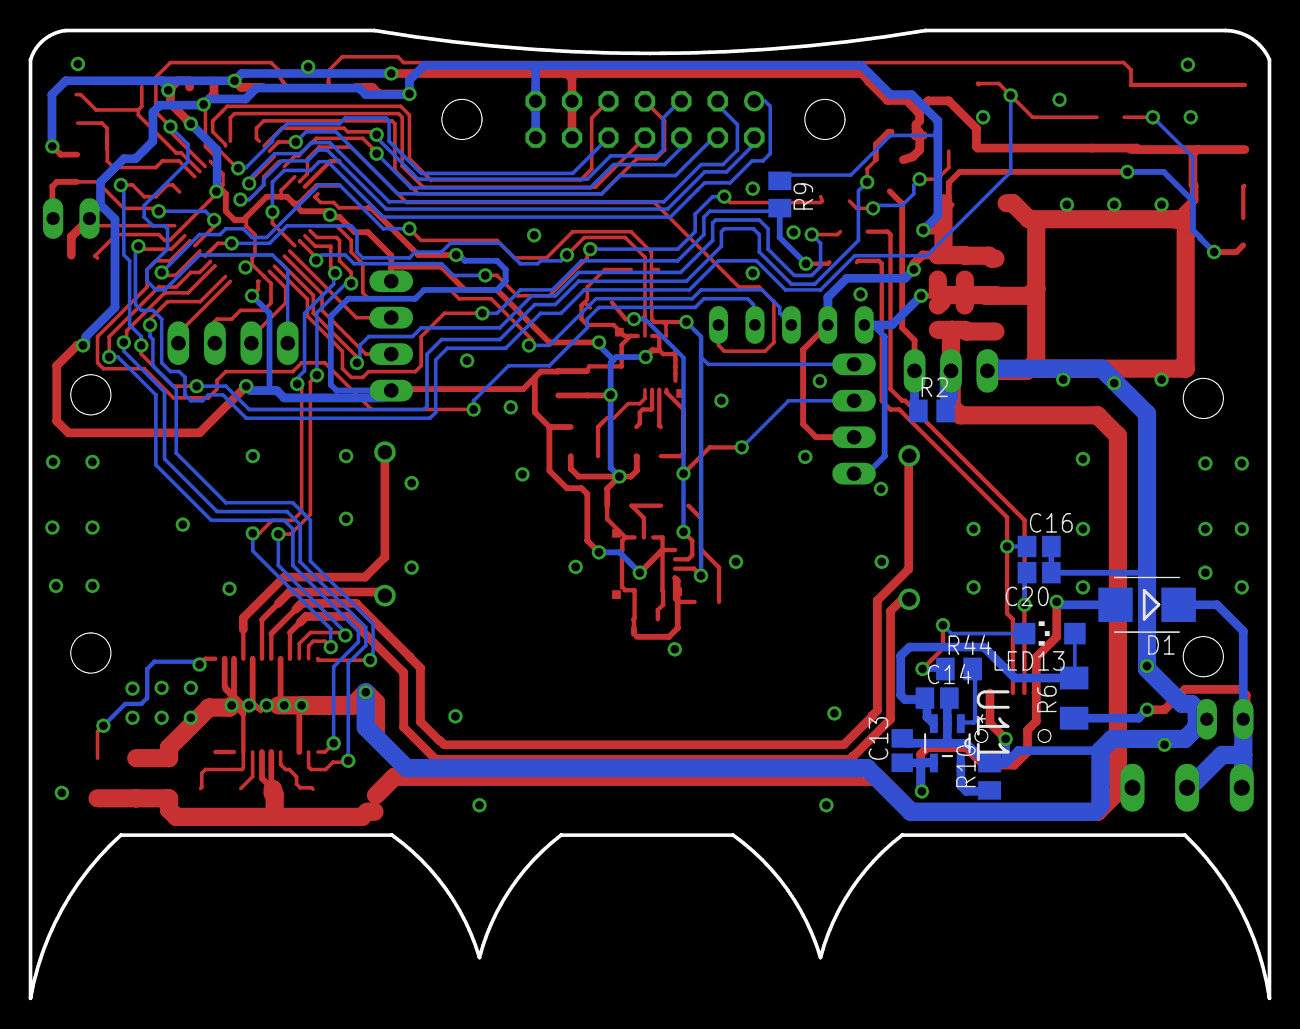
[picture p27: board hardware/main_board/main.brd from below]

Board: 2 copper layers, 86.4 x 67.5 mm, 75 parts (12 on the bottom side), 62 nets.

Parts:
BOOT: JP1
C1: 100n; C1206
C2: 10uF; C1206
C3: 10n; C1206
C4: 1uF; C1206
C5, C9, C11, C15, C19, C25, C26: 100n; C0805
C6, C10, C12, C13, C14, C27: 10uF; C0805
C7, C8: 22uF; 153CLV-0505
C16, C20: 22p; C0805
C17: 470n; C0805
C18: 10n; C0805
C21, C22: 18p; C0805
C23, C32: 4.7uF; C0805
C24: 220n; C0805
D1: SMB
H1, H2: MOUNT-HOLE2.8; 2,8
I2C_EXT: MA04-1
IC2: LM2937; TO263-3
IO1: DRV8834; DRV8834_PCK
JP1: 2 CellLi-Pol; JP1
LED11: CHIPLED_1206
LED12: poweron; CHIPLED_1206
LED13: charging; CHIPLED_1206
PROGRAMMING: MA04-1
Q1: 8MHz; CTS406
Q2MMBF170-7-F: BSS123; SOT23
R1: 47k; M1206
R2, R3, R4, R5, R15, R17, R45: 47k; M0805
R6: 0R USE ONLY FOR SINGLE CELL; M1206
R7, R8: 22; M0805
R9: 1k5; M0805
R10, R16: 10k; M0805
R13, R14: 4k7; M0805
R27, R28, R44: 330; M0805
RESET: DTSM-6
S1: 255SB
SV1: SERVO/PWM; MA03-1
SV2: FE07-2
SV3: TSL1401 CAMERA; FE05-1
U1: L3G4200D; LGA16-4X4
U2: STM32F103C6T6A; QFP50P900X900X160-48N
U3: LSM9DS0; LGA-24
U11: MCP73831T-2DCI/OT; SOT95P270X145-5N
U$1, U$2: MICRO_METAL_GEAR_MOTOR
UART: MA04-1
USER: DTSM-6
X1: MINI-USB-32005-201; 32005-201

Connections:
+3V3: BOOT.1, C5.1, C6.1, C8.+, C11.1, C12.1, C15.1, C19.2, C26.2, C27.2, I2C_EXT.2, IC2.3, R3.1, R9.1, R13.2, R14.2, R15.2, R17.2, R27.1, SV2.13, SV2.14, SV3.2, U1.1, U1.5, U1.15, U1.16, U2.9, U2.24, U2.36, U2.48, U3.15, U3.16, U3.17, U3.18, U3.19, U3.20, UART.1
ADC0: SV2.10, U2.10
ADC1: SV2.9, U2.11
ADC2: SV2.8, U2.12
ADC3: SV2.7, U2.13
ADC4: SV2.5, U2.14
ADC5: SV2.4, U2.15
ADC6: SV2.3, U2.16
ADC7: SV2.2, U2.17
ADC8: SV2.6, U2.18
AENBL: IO1.10, U2.26
APHASE: IO1.13, U2.41
BATT: D1.C, JP1.2, R6.1, S1.1, S1.2
BENBL: IO1.11, U2.27
BPHASE: IO1.12, U2.38
CAM_AO: SV3.3, U2.25
CAM_CLK: SV3.4, U2.45
CAM_SI: SV3.5, U2.21
GND: C1.2, C2.2, C4.1, C5.2, C6.2, C7.-, C8.-, C9.2, C10.2, C11.2, C12.2, C13.2, C14.2, C15.2, C16.2, C17.1, C18.1, C19.1, C20.1, C21.2, C22.2, C23.1, C25.1, C26.1, C27.1, C32.2, I2C_EXT.1, IC2.2, IO1.2, IO1.3, IO1.5, IO1.8, IO1.15, IO1.21, IO1.PAD, JP1.1, LED11.C, LED12.C, PROGRAMMING.3, Q2MMBF170-7-F.2, R4.2, R5.2, R10.2, R45.1, RESET.1, RESET.2, SV1.1, SV2.11, SV2.12, SV3.1, U1.4, U1.8, U1.9, U1.10, U1.11, U1.12, U1.13, U2.8, U2.20, U2.23, U2.35, U2.47, U3.2, U3.3, U3.4, U3.5, U3.6, U3.22, U3.23, U11.2, UART.4, USER.1, USER.2, X1.5
IR_CONTROLL: SV2.1, U2.29
LED_1: R28.2, U2.28
M1: IO1.14, U2.40
unnamed: IO1.4, U$1.P$1
unnamed: IO1.6, U$1.P$2
unnamed: IO1.9, U$2.P$1
unnamed: IO1.7, U$2.P$2
unnamed: C3.2, IO1.17
unnamed: C23.2, U3.7
unnamed: C24.2, U3.8
unnamed: IO1.22, IO1.23, IO1.24
unnamed: IO1.1, R1.2
unnamed: C24.1, U3.9
unnamed: C32.1, U2.22
unnamed: BOOT.2, R4.1, U2.44
unnamed: R44.2, U11.1
unnamed: R5.1, R17.1, U3.10
unnamed: C18.2, R16.2, U1.14
unnamed: C17.2, R16.1
unnamed: C4.2, IO1.20
unnamed: LED12.A, R27.2
unnamed: LED13.C, R44.1
unnamed: Q2MMBF170-7-F.3, R2.1, SV1.3
unnamed: LED11.A, R28.1
unnamed: C14.1, LED13.A, R6.2, U11.3
unnamed: R10.1, U11.5
unnamed: C20.2, R7.1, X1.2
unnamed: C16.1, R8.1, X1.3
unnamed: C13.1, D1.A, U11.4, X1.1
OSCIN: C22.1, Q1.3, U2.5
OSCOUT: C21.1, Q1.1, U2.6
RESET: C25.2, PROGRAMMING.1, R15.1, RESET.3, RESET.4, U2.7
SCL: I2C_EXT.3, R14.1, U1.2, U2.42, U3.21
SDA: I2C_EXT.4, R13.1, U1.3, U2.43, U3.24
SERVO: Q2MMBF170-7-F.1, R45.2, U2.2
SWCLK: PROGRAMMING.4, U2.37
SWDIO: PROGRAMMING.2, U2.34
UART_RX: U2.31, UART.2
UART_TX: U2.30, UART.3
USBDM: R7.2, U2.32
USBDP: R8.2, R9.2, U2.33
USER_KEY_1: R3.2, U2.46, USER.3
VCC: C1.1, C2.1, C3.1, C7.+, C9.1, C10.1, IC2.1, IO1.18, IO1.19, R1.1, R2.2, S1.3, SV1.2
