david20120720/motoko_after_math_linefollower/src/current/bin/main.asm

bin/main.elf:     file format elf32-littlearm


Disassembly of section .text:

08000188 <_ZN6CRobot14get_error_typeEv>:
 8000188:	6dc0      	ldr	r0, [r0, #92]	; 0x5c
 800018a:	4770      	bx	lr

0800018c <_ZN6CRobot14get_error_codeEv>:
 800018c:	6d80      	ldr	r0, [r0, #88]	; 0x58
 800018e:	4770      	bx	lr

08000190 <_ZN6CRobot13set_configureE15sRobotConfigure>:
 8000190:	b084      	sub	sp, #16
 8000192:	b530      	push	{r4, r5, lr}
 8000194:	ac04      	add	r4, sp, #16
 8000196:	e884 000e 	stmia.w	r4, {r1, r2, r3}
 800019a:	4605      	mov	r5, r0
 800019c:	cc0f      	ldmia	r4!, {r0, r1, r2, r3}
 800019e:	c50f      	stmia	r5!, {r0, r1, r2, r3}
 80001a0:	cc0f      	ldmia	r4!, {r0, r1, r2, r3}
 80001a2:	c50f      	stmia	r5!, {r0, r1, r2, r3}
 80001a4:	e894 000f 	ldmia.w	r4, {r0, r1, r2, r3}
 80001a8:	e885 000f 	stmia.w	r5, {r0, r1, r2, r3}
 80001ac:	e8bd 4030 	ldmia.w	sp!, {r4, r5, lr}
 80001b0:	b004      	add	sp, #16
 80001b2:	4770      	bx	lr

080001b4 <_ZN6CRobot19get_robot_configureEv>:
 80001b4:	4770      	bx	lr

080001b6 <_ZN6CRobot24get_line_position_sensorEv>:
 80001b6:	3030      	adds	r0, #48	; 0x30
 80001b8:	4770      	bx	lr

080001ba <_ZN6CRobot28get_obstacle_position_sensorEv>:
 80001ba:	3040      	adds	r0, #64	; 0x40
 80001bc:	4770      	bx	lr

080001be <_ZN6CRobot14get_imu_sensorEv>:
 80001be:	3048      	adds	r0, #72	; 0x48
 80001c0:	4770      	bx	lr
	...

080001c4 <_ZN6CRobot16line_sensor_readEv>:
 80001c4:	6c43      	ldr	r3, [r0, #68]	; 0x44
 80001c6:	e92d 47f0 	stmdb	sp!, {r4, r5, r6, r7, r8, r9, sl, lr}
 80001ca:	4604      	mov	r4, r0
 80001cc:	ebc3 05c3 	rsb	r5, r3, r3, lsl #3
 80001d0:	f001 fb12 	bl	80017f8 <rgb_get>
 80001d4:	f9b0 2058 	ldrsh.w	r2, [r0, #88]	; 0x58
 80001d8:	18ab      	adds	r3, r5, r2
 80001da:	2208      	movs	r2, #8
 80001dc:	fb93 f3f2 	sdiv	r3, r3, r2
 80001e0:	f9b4 2002 	ldrsh.w	r2, [r4, #2]
 80001e4:	6463      	str	r3, [r4, #68]	; 0x44
 80001e6:	4293      	cmp	r3, r2
 80001e8:	f04f 0600 	mov.w	r6, #0
 80001ec:	bfcc      	ite	gt
 80001ee:	2301      	movgt	r3, #1
 80001f0:	2300      	movle	r3, #0
 80001f2:	f884 3040 	strb.w	r3, [r4, #64]	; 0x40
 80001f6:	4637      	mov	r7, r6
 80001f8:	46b0      	mov	r8, r6
 80001fa:	46b1      	mov	r9, r6
 80001fc:	4635      	mov	r5, r6
 80001fe:	f001 fafb 	bl	80017f8 <rgb_get>
 8000202:	ea4f 0a45 	mov.w	sl, r5, lsl #1
 8000206:	4450      	add	r0, sl
 8000208:	4b97      	ldr	r3, [pc, #604]	; (8000468 <_ZN6CRobot16line_sensor_readEv+0x2a4>)
 800020a:	f853 2025 	ldr.w	r2, [r3, r5, lsl #2]
 800020e:	8ec3      	ldrh	r3, [r0, #54]	; 0x36
 8000210:	1a9b      	subs	r3, r3, r2
 8000212:	86c3      	strh	r3, [r0, #54]	; 0x36
 8000214:	f001 faf0 	bl	80017f8 <rgb_get>
 8000218:	4b94      	ldr	r3, [pc, #592]	; (800046c <_ZN6CRobot16line_sensor_readEv+0x2a8>)
 800021a:	f853 2025 	ldr.w	r2, [r3, r5, lsl #2]
 800021e:	f830 3015 	ldrh.w	r3, [r0, r5, lsl #1]
 8000222:	1a9b      	subs	r3, r3, r2
 8000224:	f820 3015 	strh.w	r3, [r0, r5, lsl #1]
 8000228:	f001 fae6 	bl	80017f8 <rgb_get>
 800022c:	4b90      	ldr	r3, [pc, #576]	; (8000470 <_ZN6CRobot16line_sensor_readEv+0x2ac>)
 800022e:	4450      	add	r0, sl
 8000230:	f853 2025 	ldr.w	r2, [r3, r5, lsl #2]
 8000234:	8a43      	ldrh	r3, [r0, #18]
 8000236:	1a9b      	subs	r3, r3, r2
 8000238:	8243      	strh	r3, [r0, #18]
 800023a:	f001 fadd 	bl	80017f8 <rgb_get>
 800023e:	4b8d      	ldr	r3, [pc, #564]	; (8000474 <_ZN6CRobot16line_sensor_readEv+0x2b0>)
 8000240:	4450      	add	r0, sl
 8000242:	f853 2025 	ldr.w	r2, [r3, r5, lsl #2]
 8000246:	8c83      	ldrh	r3, [r0, #36]	; 0x24
 8000248:	1a9b      	subs	r3, r3, r2
 800024a:	8483      	strh	r3, [r0, #36]	; 0x24
 800024c:	f001 fad4 	bl	80017f8 <rgb_get>
 8000250:	eb00 0045 	add.w	r0, r0, r5, lsl #1
 8000254:	f9b0 3036 	ldrsh.w	r3, [r0, #54]	; 0x36
 8000258:	4499      	add	r9, r3
 800025a:	f001 facd 	bl	80017f8 <rgb_get>
 800025e:	f930 3015 	ldrsh.w	r3, [r0, r5, lsl #1]
 8000262:	4498      	add	r8, r3
 8000264:	f001 fac8 	bl	80017f8 <rgb_get>
 8000268:	eb00 0045 	add.w	r0, r0, r5, lsl #1
 800026c:	f9b0 3012 	ldrsh.w	r3, [r0, #18]
 8000270:	441f      	add	r7, r3
 8000272:	f001 fac1 	bl	80017f8 <rgb_get>
 8000276:	eb00 0045 	add.w	r0, r0, r5, lsl #1
 800027a:	3501      	adds	r5, #1
 800027c:	f9b0 3024 	ldrsh.w	r3, [r0, #36]	; 0x24
 8000280:	2d08      	cmp	r5, #8
 8000282:	441e      	add	r6, r3
 8000284:	d1bb      	bne.n	80001fe <_ZN6CRobot16line_sensor_readEv+0x3a>
 8000286:	fb99 f9f5 	sdiv	r9, r9, r5
 800028a:	fb98 f8f5 	sdiv	r8, r8, r5
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
 8000968:	4801      	ldr	r0, [pc, #4]	; (8000970 <_Z18line_sensor_threadv+0x18>)
 800096a:	f7ff fd87 	bl	800047c <_ZN6CRobot19process_rgb_sensorsEv>
 800096e:	e7f8      	b.n	8000962 <_Z18line_sensor_threadv+0xa>
 8000970:	2000093c 	.word	0x2000093c

08000974 <_Z17imu_sensor_threadv>:
 8000974:	b508      	push	{r3, lr}
 8000976:	2001      	movs	r0, #1
 8000978:	210a      	movs	r1, #10
 800097a:	f001 fb23 	bl	8001fc4 <event_timer_set_period>
 800097e:	2001      	movs	r0, #1
 8000980:	f001 fb38 	bl	8001ff4 <event_timer_wait>
 8000984:	4805      	ldr	r0, [pc, #20]	; (800099c <_Z17imu_sensor_threadv+0x28>)
 8000986:	f7ff feba 	bl	80006fe <_ZN6CRobot18process_imu_sensorEv>
 800098a:	4b05      	ldr	r3, [pc, #20]	; (80009a0 <_Z17imu_sensor_threadv+0x2c>)
 800098c:	681b      	ldr	r3, [r3, #0]
 800098e:	2b00      	cmp	r3, #0
 8000990:	d0f5      	beq.n	800097e <_Z17imu_sensor_threadv+0xa>
 8000992:	4804      	ldr	r0, [pc, #16]	; (80009a4 <_Z17imu_sensor_threadv+0x30>)
 8000994:	f7ff ffae 	bl	80008f4 <_ZN4CMap10add_to_mapEv>
 8000998:	e7f1      	b.n	800097e <_Z17imu_sensor_threadv+0xa>
 800099a:	bf00      	nop
 800099c:	2000093c 	.word	0x2000093c
 80009a0:	20000d20 	.word	0x20000d20
 80009a4:	2000052c 	.word	0x2000052c

080009a8 <_Z16telemetry_threadv>:
 80009a8:	b573      	push	{r0, r1, r4, r5, r6, lr}
 80009aa:	4865      	ldr	r0, [pc, #404]	; (8000b40 <_Z16telemetry_threadv+0x198>)
 80009ac:	f000 fbf2 	bl	8001194 <printf_>
 80009b0:	4864      	ldr	r0, [pc, #400]	; (8000b44 <_Z16telemetry_threadv+0x19c>)
 80009b2:	f7ff fbff 	bl	80001b4 <_ZN6CRobot19get_robot_configureEv>
 80009b6:	f9b0 5000 	ldrsh.w	r5, [r0]
 80009ba:	4862      	ldr	r0, [pc, #392]	; (8000b44 <_Z16telemetry_threadv+0x19c>)
 80009bc:	f7ff fbfa 	bl	80001b4 <_ZN6CRobot19get_robot_configureEv>
 80009c0:	f9b0 4002 	ldrsh.w	r4, [r0, #2]
 80009c4:	485f      	ldr	r0, [pc, #380]	; (8000b44 <_Z16telemetry_threadv+0x19c>)
 80009c6:	f7ff fbf5 	bl	80001b4 <_ZN6CRobot19get_robot_configureEv>
 80009ca:	4629      	mov	r1, r5
 80009cc:	7903      	ldrb	r3, [r0, #4]
 80009ce:	485e      	ldr	r0, [pc, #376]	; (8000b48 <_Z16telemetry_threadv+0x1a0>)
 80009d0:	4622      	mov	r2, r4
 80009d2:	f000 fbdf 	bl	8001194 <printf_>
 80009d6:	485b      	ldr	r0, [pc, #364]	; (8000b44 <_Z16telemetry_threadv+0x19c>)
 80009d8:	f7ff fbec 	bl	80001b4 <_ZN6CRobot19get_robot_configureEv>
 80009dc:	6886      	ldr	r6, [r0, #8]
 80009de:	4859      	ldr	r0, [pc, #356]	; (8000b44 <_Z16telemetry_threadv+0x19c>)
 80009e0:	f7ff fbe8 	bl	80001b4 <_ZN6CRobot19get_robot_configureEv>
 80009e4:	68c5      	ldr	r5, [r0, #12]
 80009e6:	4857      	ldr	r0, [pc, #348]	; (8000b44 <_Z16telemetry_threadv+0x19c>)
 80009e8:	f7ff fbe4 	bl	80001b4 <_ZN6CRobot19get_robot_configureEv>
 80009ec:	6904      	ldr	r4, [r0, #16]
 80009ee:	4855      	ldr	r0, [pc, #340]	; (8000b44 <_Z16telemetry_threadv+0x19c>)
 80009f0:	f7ff fbe0 	bl	80001b4 <_ZN6CRobot19get_robot_configureEv>
 80009f4:	6943      	ldr	r3, [r0, #20]
 80009f6:	9300      	str	r3, [sp, #0]
 80009f8:	4631      	mov	r1, r6
 80009fa:	462a      	mov	r2, r5
 80009fc:	4623      	mov	r3, r4
 80009fe:	4853      	ldr	r0, [pc, #332]	; (8000b4c <_Z16telemetry_threadv+0x1a4>)
 8000a00:	f000 fbc8 	bl	8001194 <printf_>
 8000a04:	484f      	ldr	r0, [pc, #316]	; (8000b44 <_Z16telemetry_threadv+0x19c>)
 8000a06:	f7ff fbd5 	bl	80001b4 <_ZN6CRobot19get_robot_configureEv>
 8000a0a:	6a06      	ldr	r6, [r0, #32]
 8000a0c:	484d      	ldr	r0, [pc, #308]	; (8000b44 <_Z16telemetry_threadv+0x19c>)
 8000a0e:	f7ff fbd1 	bl	80001b4 <_ZN6CRobot19get_robot_configureEv>
 8000a12:	6a45      	ldr	r5, [r0, #36]	; 0x24
 8000a14:	484b      	ldr	r0, [pc, #300]	; (8000b44 <_Z16telemetry_threadv+0x19c>)
 8000a16:	f7ff fbcd 	bl	80001b4 <_ZN6CRobot19get_robot_configureEv>
 8000a1a:	6a84      	ldr	r4, [r0, #40]	; 0x28
 8000a1c:	4849      	ldr	r0, [pc, #292]	; (8000b44 <_Z16telemetry_threadv+0x19c>)
 8000a1e:	f7ff fbc9 	bl	80001b4 <_ZN6CRobot19get_robot_configureEv>
 8000a22:	6ac3      	ldr	r3, [r0, #44]	; 0x2c
 8000a24:	9300      	str	r3, [sp, #0]
 8000a26:	4631      	mov	r1, r6
 8000a28:	462a      	mov	r2, r5
 8000a2a:	4623      	mov	r3, r4
 8000a2c:	4848      	ldr	r0, [pc, #288]	; (8000b50 <_Z16telemetry_threadv+0x1a8>)
 8000a2e:	f000 fbb1 	bl	8001194 <printf_>
 8000a32:	4848      	ldr	r0, [pc, #288]	; (8000b54 <_Z16telemetry_threadv+0x1ac>)
 8000a34:	f000 fbae 	bl	8001194 <printf_>
 8000a38:	4847      	ldr	r0, [pc, #284]	; (8000b58 <_Z16telemetry_threadv+0x1b0>)
 8000a3a:	f000 fbab 	bl	8001194 <printf_>
 8000a3e:	4841      	ldr	r0, [pc, #260]	; (8000b44 <_Z16telemetry_threadv+0x19c>)
 8000a40:	f7ff fbb9 	bl	80001b6 <_ZN6CRobot24get_line_position_sensorEv>
 8000a44:	7806      	ldrb	r6, [r0, #0]
 8000a46:	483f      	ldr	r0, [pc, #252]	; (8000b44 <_Z16telemetry_threadv+0x19c>)
 8000a48:	f7ff fbb5 	bl	80001b6 <_ZN6CRobot24get_line_position_sensorEv>
 8000a4c:	6845      	ldr	r5, [r0, #4]
 8000a4e:	483d      	ldr	r0, [pc, #244]	; (8000b44 <_Z16telemetry_threadv+0x19c>)
 8000a50:	f7ff fbb1 	bl	80001b6 <_ZN6CRobot24get_line_position_sensorEv>
 8000a54:	6884      	ldr	r4, [r0, #8]
 8000a56:	483b      	ldr	r0, [pc, #236]	; (8000b44 <_Z16telemetry_threadv+0x19c>)
 8000a58:	f7ff fbad 	bl	80001b6 <_ZN6CRobot24get_line_position_sensorEv>
 8000a5c:	68c3      	ldr	r3, [r0, #12]
 8000a5e:	9300      	str	r3, [sp, #0]
 8000a60:	4631      	mov	r1, r6
 8000a62:	4623      	mov	r3, r4
 8000a64:	462a      	mov	r2, r5
 8000a66:	483d      	ldr	r0, [pc, #244]	; (8000b5c <_Z16telemetry_threadv+0x1b4>)
 8000a68:	f000 fb94 	bl	8001194 <printf_>
 8000a6c:	4839      	ldr	r0, [pc, #228]	; (8000b54 <_Z16telemetry_threadv+0x1ac>)
 8000a6e:	f000 fb91 	bl	8001194 <printf_>
 8000a72:	483b      	ldr	r0, [pc, #236]	; (8000b60 <_Z16telemetry_threadv+0x1b8>)
 8000a74:	f000 fb8e 	bl	8001194 <printf_>
 8000a78:	4832      	ldr	r0, [pc, #200]	; (8000b44 <_Z16telemetry_threadv+0x19c>)
 8000a7a:	f7ff fb9e 	bl	80001ba <_ZN6CRobot28get_obstacle_position_sensorEv>
 8000a7e:	7804      	ldrb	r4, [r0, #0]
 8000a80:	4830      	ldr	r0, [pc, #192]	; (8000b44 <_Z16telemetry_threadv+0x19c>)
 8000a82:	f7ff fb9a 	bl	80001ba <_ZN6CRobot28get_obstacle_position_sensorEv>
 8000a86:	4603      	mov	r3, r0
 8000a88:	4621      	mov	r1, r4
 8000a8a:	685a      	ldr	r2, [r3, #4]
 8000a8c:	4835      	ldr	r0, [pc, #212]	; (8000b64 <_Z16telemetry_threadv+0x1bc>)
 8000a8e:	f000 fb81 	bl	8001194 <printf_>
 8000a92:	4830      	ldr	r0, [pc, #192]	; (8000b54 <_Z16telemetry_threadv+0x1ac>)
 8000a94:	f000 fb7e 	bl	8001194 <printf_>
 8000a98:	4833      	ldr	r0, [pc, #204]	; (8000b68 <_Z16telemetry_threadv+0x1c0>)
 8000a9a:	f000 fb7b 	bl	8001194 <printf_>
 8000a9e:	2400      	movs	r4, #0
 8000aa0:	4828      	ldr	r0, [pc, #160]	; (8000b44 <_Z16telemetry_threadv+0x19c>)
 8000aa2:	f7ff fda5 	bl	80005f0 <_ZN6CRobot28get_line_sensor_raw_data_difEv>
 8000aa6:	5f01      	ldrsh	r1, [r0, r4]
 8000aa8:	4830      	ldr	r0, [pc, #192]	; (8000b6c <_Z16telemetry_threadv+0x1c4>)
 8000aaa:	3402      	adds	r4, #2
 8000aac:	f000 fb72 	bl	8001194 <printf_>
 8000ab0:	2c10      	cmp	r4, #16
 8000ab2:	d1f5      	bne.n	8000aa0 <_Z16telemetry_threadv+0xf8>
 8000ab4:	482e      	ldr	r0, [pc, #184]	; (8000b70 <_Z16telemetry_threadv+0x1c8>)
 8000ab6:	f000 fb6d 	bl	8001194 <printf_>
 8000aba:	2400      	movs	r4, #0
 8000abc:	f000 fe9c 	bl	80017f8 <rgb_get>
 8000ac0:	eb00 0344 	add.w	r3, r0, r4, lsl #1
 8000ac4:	4829      	ldr	r0, [pc, #164]	; (8000b6c <_Z16telemetry_threadv+0x1c4>)
 8000ac6:	f9b3 1036 	ldrsh.w	r1, [r3, #54]	; 0x36
 8000aca:	3401      	adds	r4, #1
 8000acc:	f000 fb62 	bl	8001194 <printf_>
 8000ad0:	2c08      	cmp	r4, #8
 8000ad2:	d1f3      	bne.n	8000abc <_Z16telemetry_threadv+0x114>
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
 8001d42:	894b      	ldrh	r3, [r1, #10]
 8001d44:	8603      	strh	r3, [r0, #48]	; 0x30
 8001d46:	2301      	movs	r3, #1
 8001d48:	6143      	str	r3, [r0, #20]
 8001d4a:	4770      	bx	lr
 8001d4c:	40012c00 	.word	0x40012c00
 8001d50:	40001000 	.word	0x40001000

08001d54 <TIM_Cmd>:
 8001d54:	bf00      	nop
 8001d56:	bf00      	nop
 8001d58:	8803      	ldrh	r3, [r0, #0]
 8001d5a:	b119      	cbz	r1, 8001d64 <TIM_Cmd+0x10>
 8001d5c:	b29b      	uxth	r3, r3
 8001d5e:	f043 0301 	orr.w	r3, r3, #1
 8001d62:	e003      	b.n	8001d6c <TIM_Cmd+0x18>
 8001d64:	f023 0301 	bic.w	r3, r3, #1
 8001d68:	041b      	lsls	r3, r3, #16
 8001d6a:	0c1b      	lsrs	r3, r3, #16
 8001d6c:	8003      	strh	r3, [r0, #0]
 8001d6e:	4770      	bx	lr
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
