david20120720/motoko_after_math_linefollower/src/2.1.0/bin/main.asm

bin/main.elf:     file format elf32-littlearm


Disassembly of section .text:

08000188 <_ZN6CRobot14get_error_typeEv>:
 8000188:	6dc0      	ldr	r0, [r0, #92]	; 0x5c
 800018a:	4770      	bx	lr

0800018c <_ZN6CRobot14get_error_codeEv>:
 800018c:	6d80      	ldr	r0, [r0, #88]	; 0x58
 800018e:	4770      	bx	lr

08000190 <_ZN6CRobot13set_configureE15sRobotConfigure>:
 8000190:	b084      	sub	sp, #16
 8000192:	b530      	push	{r4, r5, lr}
 8000194:	ac04      	add	r4, sp, #16
 8000196:	e884 000e 	stmia.w	r4, {r1, r2, r3}
 800019a:	4605      	mov	r5, r0
 800019c:	cc0f      	ldmia	r4!, {r0, r1, r2, r3}
 800019e:	c50f      	stmia	r5!, {r0, r1, r2, r3}
 80001a0:	cc0f      	ldmia	r4!, {r0, r1, r2, r3}
 80001a2:	c50f      	stmia	r5!, {r0, r1, r2, r3}
 80001a4:	e894 000f 	ldmia.w	r4, {r0, r1, r2, r3}
 80001a8:	e885 000f 	stmia.w	r5, {r0, r1, r2, r3}
 80001ac:	e8bd 4030 	ldmia.w	sp!, {r4, r5, lr}
 80001b0:	b004      	add	sp, #16
 80001b2:	4770      	bx	lr

080001b4 <_ZN6CRobot19get_robot_configureEv>:
 80001b4:	4770      	bx	lr

080001b6 <_ZN6CRobot24get_line_position_sensorEv>:
 80001b6:	3030      	adds	r0, #48	; 0x30
 80001b8:	4770      	bx	lr

080001ba <_ZN6CRobot28get_obstacle_position_sensorEv>:
 80001ba:	3040      	adds	r0, #64	; 0x40
 80001bc:	4770      	bx	lr

080001be <_ZN6CRobot14get_imu_sensorEv>:
 80001be:	3048      	adds	r0, #72	; 0x48
 80001c0:	4770      	bx	lr

080001c2 <_ZN6CRobot10set_motorsEii>:
 80001c2:	4608      	mov	r0, r1
 80001c4:	4611      	mov	r1, r2
 80001c6:	f002 bcc7 	b.w	8002b58 <drv8834_run>

080001ca <_ZN6CRobot9reset_imuEv>:
 80001ca:	2300      	movs	r3, #0
 80001cc:	6483      	str	r3, [r0, #72]	; 0x48
 80001ce:	64c3      	str	r3, [r0, #76]	; 0x4c
 80001d0:	6503      	str	r3, [r0, #80]	; 0x50
 80001d2:	4770      	bx	lr

080001d4 <_ZN6CRobot16line_sensor_readEv>:
 80001d4:	6c43      	ldr	r3, [r0, #68]	; 0x44
 80001d6:	e92d 47f0 	stmdb	sp!, {r4, r5, r6, r7, r8, r9, sl, lr}
 80001da:	4604      	mov	r4, r0
 80001dc:	ebc3 05c3 	rsb	r5, r3, r3, lsl #3
 80001e0:	f001 fd2c 	bl	8001c3c <rgb_get>
 80001e4:	f9b0 2058 	ldrsh.w	r2, [r0, #88]	; 0x58
 80001e8:	18ab      	adds	r3, r5, r2
 80001ea:	2208      	movs	r2, #8
 80001ec:	fb93 f3f2 	sdiv	r3, r3, r2
 80001f0:	f9b4 2002 	ldrsh.w	r2, [r4, #2]
 80001f4:	6463      	str	r3, [r4, #68]	; 0x44
 80001f6:	4293      	cmp	r3, r2
 80001f8:	f04f 0600 	mov.w	r6, #0
 80001fc:	bfcc      	ite	gt
 80001fe:	2301      	movgt	r3, #1
 8000200:	2300      	movle	r3, #0
 8000202:	f884 3040 	strb.w	r3, [r4, #64]	; 0x40
 8000206:	4637      	mov	r7, r6
 8000208:	46b0      	mov	r8, r6
 800020a:	46b1      	mov	r9, r6
 800020c:	4635      	mov	r5, r6
 800020e:	f001 fd15 	bl	8001c3c <rgb_get>
 8000212:	ea4f 0a45 	mov.w	sl, r5, lsl #1
 8000216:	4450      	add	r0, sl
 8000218:	4b88      	ldr	r3, [pc, #544]	; (800043c <_ZN6CRobot16line_sensor_readEv+0x268>)
 800021a:	f853 2025 	ldr.w	r2, [r3, r5, lsl #2]
 800021e:	8ec3      	ldrh	r3, [r0, #54]	; 0x36
 8000220:	1a9b      	subs	r3, r3, r2
 8000222:	86c3      	strh	r3, [r0, #54]	; 0x36
 8000224:	f001 fd0a 	bl	8001c3c <rgb_get>
 8000228:	4b85      	ldr	r3, [pc, #532]	; (8000440 <_ZN6CRobot16line_sensor_readEv+0x26c>)
 800022a:	f853 2025 	ldr.w	r2, [r3, r5, lsl #2]
 800022e:	f830 3015 	ldrh.w	r3, [r0, r5, lsl #1]
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
 8001d74:	f7ff be59 	b.w	8001a2a <rgb_i2cStop>
 8001d78:	20000e0c 	.word	0x20000e0c
 8001d7c:	20000e34 	.word	0x20000e34
 8001d80:	20000dd8 	.word	0x20000dd8
 8001d84:	20000de8 	.word	0x20000de8
 8001d88:	20000dfa 	.word	0x20000dfa
 8001d8c:	20000e1e 	.word	0x20000e1e

08001d90 <main>:
 8001d90:	b508      	push	{r3, lr}
 8001d92:	f000 ff79 	bl	8002c88 <lib_low_level_init>
 8001d96:	f7ff fc3d 	bl	8001614 <lib_os_init>
 8001d9a:	4905      	ldr	r1, [pc, #20]	; (8001db0 <main+0x20>)
 8001d9c:	4805      	ldr	r0, [pc, #20]	; (8001db4 <main+0x24>)
 8001d9e:	f44f 7200 	mov.w	r2, #512	; 0x200
 8001da2:	2306      	movs	r3, #6
 8001da4:	f7ff fa72 	bl	800128c <create_thread>
 8001da8:	f7ff fa6a 	bl	8001280 <kernel_start>
 8001dac:	2000      	movs	r0, #0
 8001dae:	bd08      	pop	{r3, pc}
 8001db0:	20000e40 	.word	0x20000e40
 8001db4:	08000c3d 	.word	0x08000c3d
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
