david20120720/motoko_after_math_linefollower/src/current/lib_usr/lib_usr.h

#ifndef _LIB_USR_H_
#define _LIB_USR_H_

#include "../device/device.h"
#include "../os/suzuha_os.h"

#include "common/math.h"          /*basic math*/
#include "common/pid.h"           /*pid controller*/


#include "sensors/rgb_i2c.h"       /*rgb sensor*/

#include "sensors/camera.h"       /*line scan camera*/

#include "error.h"

#include "robot.h"



#endif
