david20120720/motoko_after_math_linefollower/src/2.1.0/device/stm32f30x/lib_low_level/lib_low_level.h

#ifndef LIB_LOW_LEVEL_H_
#define LIB_LOW_LEVEL_H_


#ifdef __cplusplus
extern "C" {
#endif

#include "int_def.h"
#include "core/stm32f30x.h"
#include "core/cortex_cpu.h"
#include "core/core_cm4_simd.h"

#include "misc.h"
#include "stm32f30x_rcc.h"

#include "timer/stm32f30x_tim.h"
#include "adc/stm32f30x_adc.h"



#include "gpio/gpio.h"
#include "timer/timer.h"
#include "pwm/pwm.h"

#include "pwm/drv8834.h"

#include "uart/uart.h"
#include "i2c/i2c.h"

#include "adc/adc.h"
#include "spi/spi.h"



#include "../../../options.h"


void lib_low_level_init();

#ifdef __cplusplus
}
#endif

#endif
