david20120720/motoko_after_math_linefollower/src/2.1.0/device/stm32f30x/lib_low_level/uart/uart.h

#ifndef _UART_H_
#define _UART_H_

#include "../lib_low_level.h"

#ifdef __cplusplus
extern "C" {
#endif

//#define UART_BAUD_RATE    9600
//#define UART_BAUD_RATE 		57600

#define UART_BAUD_RATE 		115200


void uart_write(char c);
char uart_read();
u16 uart_is_char();
void uart_init();
void uart_clear_buffer();

#ifdef __cplusplus
}
#endif

#endif
