david20120720/motoko_after_math_linefollower/src/1.7.0/device/stm32f10x/lib_low_level/uart/uart.c

#include "uart.h"
#include "stm32f10x_usart.h"

void uart_write(char c)
{
	while( !(USART1->SR & 0x00000040) )
		__asm("nop");
	
	USART1->DR = c;
}


char uart_read()
{
	char res;

	while( !(USART1->SR & USART_SR_RXNE) )
		__asm("nop");

	res = USART1->DR;

  return res;
}

void uart_init()
{
  GPIO_InitTypeDef GPIO_InitStructure;
  USART_InitTypeDef USART_InitStructure;

  RCC_APB2PeriphClockCmd(RCC_APB2Periph_USART1, ENABLE );


  /* Clock configuration -------------------------------------------------------*/

  /* Configure the GPIO ports( USART1 Transmit and Receive Lines) */
  /* Configure the USART1_Tx as Alternate function Push-Pull */
  GPIO_InitStructure.GPIO_Mode = GPIO_Mode_AF_PP;
  GPIO_InitStructure.GPIO_Pin =  GPIO_Pin_9;
  GPIO_InitStructure.GPIO_Speed = GPIO_Speed_50MHz;
  GPIO_Init(GPIOA, &GPIO_InitStructure);

  /* Configure the USART1_Rx as input floating */
  GPIO_InitStructure.GPIO_Mode = GPIO_Mode_IN_FLOATING;
  GPIO_InitStructure.GPIO_Pin = GPIO_Pin_10 ;
  GPIO_Init(GPIOA, &GPIO_InitStructure);

  /* USART1 configuration ------------------------------------------------------*/
  /* USART1 configured as follow:
    - BaudRate = 115200 baud  
    - Word Length = 8 Bits
    - One Stop Bit
    - No parity
    - Hardware flow control disabled (RTS and CTS signals)
    - Receive and transmit enabled
  */
  USART_InitStructure.USART_BaudRate = UART_BAUD_RATE;
  USART_InitStructure.USART_WordLength = USART_WordLength_8b;
  USART_InitStructure.USART_StopBits = USART_StopBits_1;
  USART_InitStructure.USART_Parity = USART_Parity_No;
  USART_InitStructure.USART_HardwareFlowControl = USART_HardwareFlowControl_None;
  USART_InitStructure.USART_Mode = USART_Mode_Rx | USART_Mode_Tx;

  /* Configure the USART1 */
  USART_Init(USART1, &USART_InitStructure);

  /* Enable the USART1 */
  USART_Cmd(USART1, ENABLE);
}
