david20120720/motoko_after_math_linefollower/src/2.1.0/device/stm32f30x/lib_low_level/spi/spi.c

#include "spi.h"


void spi_init()
{
	u32 i; 
 
 	/*
	GPIO_InitTypeDef  GPIO_InitStructure;

	GPIO_InitStructure.GPIO_Pin = SCK|MOSI;
    GPIO_InitStructure.GPIO_Mode = GPIO_Mode_Out_PP;
    GPIO_InitStructure.GPIO_Speed = GPIO_Speed_50MHz;
    GPIO_Init(SPI_GPIO, &GPIO_InitStructure);

    GPIO_InitStructure.GPIO_Pin = MISO; 
    GPIO_InitStructure.GPIO_Mode = GPIO_Mode_IPD;
    GPIO_InitStructure.GPIO_Speed = GPIO_Speed_50MHz;
    GPIO_Init(SPI_GPIO, &GPIO_InitStructure);

	GPIO_ResetBits(SPI_GPIO, SCK);
	GPIO_ResetBits(SPI_GPIO, MOSI);
	*/

	for (i = 0; i < 32; i++) 
		spib(0xff);
} 

#if SPI_DELAY_CYCLES > 1

void spi_delay() 
{
	u32 i = SPI_DELAY_CYCLES; 
	while (i--)
		__asm("nop");
}

#else

#define spi_delay() __asm("nop");

#endif

u8 spib(u8 b)
{
	/*
	u32 i;

	for (i = 0; i < 8; i++)
	{
		if (b&(1<<7))
			SPI_GPIO->BSRR = MOSI;
		else
			SPI_GPIO->BRR = MOSI;

		spi_delay();

		SPI_GPIO->BSRR = SCK;

		spi_delay();

		b<<=1;

		if ((SPI_GPIO->IDR&MISO) != 0)
			b|= (1<<0);

		SPI_GPIO->BRR = SCK;

		spi_delay();
	}

	SPI_GPIO->BRR = MOSI;
	spi_delay();
	*/

	return b;
}


void spi_block_read(u8 *buffer, u32 buffer_size)
{
	u32 i;

	for (i = 0; i < buffer_size; i++)
		buffer[i] = spib(0xff);
}

void SPI_CS_INIT()
{
	/*
	GPIO_InitTypeDef  GPIO_InitStructure;

	GPIO_InitStructure.GPIO_Pin = SPI_CS_PIN;
    GPIO_InitStructure.GPIO_Mode = GPIO_Mode_Out_PP;
    GPIO_InitStructure.GPIO_Speed = GPIO_Speed_50MHz;
    GPIO_Init(SPI_CS_GPIO, &GPIO_InitStructure);

    SPI_CS_HIGH();
    */
}

void SPI_CS_LOW()
{
	// SPI_CS_GPIO->BRR = SPI_CS_PIN;
}

void SPI_CS_HIGH()
{
	// SPI_CS_GPIO->BSRR = SPI_CS_PIN;
}
