david20120720/motoko_after_math_linefollower/src/2.1.0/usr/q_predictor.cpp

#include "q_predictor.h"

float predictor_output[Q_PREDICTOR_MODELS_COUNT] =
    {0.0, 0.0, 0.0, 0.0, 0.0, 0.0, 0.0, 0.0};

float predictor_hard_locations[Q_PREDICTOR_MODELS_COUNT][Q_PREDICTOR_MODEL_SIZE] =
    {
      {0.0, 0.0, 0.0, 0.0, 0.0, 0.0, 0.0, 0.0, 0.0, 0.0, 0.0, 0.0, 0.0, 0.0, 0.0, 0.0},
      {0.3, 0.3, 0.3, 0.3, 0.3, 0.3, 0.3, 0.3, 0.3, 0.3, 0.3, 0.3, 0.3, 0.3, 0.3, 0.3},
      {0.6, 0.6, 0.6, 0.6, 0.6, 0.6, 0.6, 0.6, 0.6, 0.6, 0.6, 0.6, 0.6, 0.6, 0.6, 0.6},
      {0.8, 0.8, 0.8, 0.8, 0.8, 0.8, 0.8, 0.8, 0.8, 0.8, 0.8, 0.8, 0.8, 0.8, 0.8, 0.8},

      {0.000, 0.012, 0.050, 0.113, 0.200, 0.312, 0.450, 0.613, 0.800, 1.000, 1.000, 1.000, 1.000, 1.000, 1.000, 1.000},
      {0.000, 0.000, 0.012, 0.050, 0.113, 0.200, 0.312, 0.450, 0.613, 0.800, 1.000, 1.000, 1.000, 1.000, 1.000, 1.000},
      {0.000, 0.000, 0.000, 0.012, 0.050, 0.113, 0.200, 0.312, 0.450, 0.613, 0.800, 1.000, 1.000, 1.000, 1.000, 1.000},
      {0.000, 0.000, 0.000, 0.000, 0.012, 0.050, 0.113, 0.200, 0.312, 0.450, 0.613, 0.800, 1.000, 1.000, 1.000, 1.000},
      {0.000, 0.000, 0.000, 0.000, 0.000, 0.012, 0.050, 0.113, 0.200, 0.312, 0.450, 0.613, 0.800, 1.000, 1.000, 1.000},
      {0.000, 0.000, 0.000, 0.000, 0.000, 0.000, 0.012, 0.050, 0.113, 0.200, 0.312, 0.450, 0.613, 0.800, 1.000, 1.000},
      {0.000, 0.000, 0.000, 0.000, 0.000, 0.000, 0.000, 0.012, 0.050, 0.113, 0.200, 0.312, 0.450, 0.613, 0.800, 1.000},

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

  return -m_sgn(input_sample)*predictor_output[dist_min_idx];
}

void CQPredictor::print()
{
  printf_("> %u : ", dist_min_idx);
  u32 i;
  for (i = 0; i < Q_PREDICTOR_MODELS_COUNT; i++)
    printf_("%i ", (i32)(predictor_output[i]*1000) );
  printf_("\n");
}
