david20120720/motoko_after_math_linefollower/src/2.1.0/device/qemu/lib_low_level/core/systick.h

#ifndef _SYSTICK_H_
#define _SYSTICK_H_

/**
 * @addtogroup SysTick_Peripheral SysTick
 * @{
 */

/** SysTick - Peripheral register structure */
typedef struct SysTick_MemMap {
  uint32_t CSR;                                    /**< SysTick Control and Status Register, offset: 0x0 */
  uint32_t RVR;                                    /**< SysTick Reload Value Register, offset: 0x4 */
  uint32_t CVR;                                    /**< SysTick Current Value Register, offset: 0x8 */
  uint32_t CALIB;                                  /**< SysTick Calibration Value Register, offset: 0xC */
} volatile *SysTick_MemMapPtr;

/* ----------------------------------------------------------------------------
   -- SysTick - Register accessor macros
   ---------------------------------------------------------------------------- */

/**
 * @addtogroup SysTick_Register_Accessor_Macros SysTick - Register accessor macros
 * @{
 */


/* SysTick - Register accessors */
#define SysTick_CSR_REG(base)                    ((base)->CSR)
#define SysTick_RVR_REG(base)                    ((base)->RVR)
#define SysTick_CVR_REG(base)                    ((base)->CVR)
#define SysTick_CALIB_REG(base)                  ((base)->CALIB)

/**
 * @}
 */ /* end of group SysTick_Register_Accessor_Macros */


/* ----------------------------------------------------------------------------
   -- SysTick Register Masks
   ---------------------------------------------------------------------------- */

/**
 * @addtogroup SysTick_Register_Masks SysTick Register Masks
 * @{
 */

/* CSR Bit Fields */
#define SysTick_CSR_ENABLE_MASK                  0x1u
#define SysTick_CSR_ENABLE_SHIFT                 0
#define SysTick_CSR_TICKINT_MASK                 0x2u
#define SysTick_CSR_TICKINT_SHIFT                1
#define SysTick_CSR_CLKSOURCE_MASK               0x4u
#define SysTick_CSR_CLKSOURCE_SHIFT              2
#define SysTick_CSR_COUNTFLAG_MASK               0x10000u
#define SysTick_CSR_COUNTFLAG_SHIFT              16
/* RVR Bit Fields */
#define SysTick_RVR_RELOAD_MASK                  0xFFFFFFu
#define SysTick_RVR_RELOAD_SHIFT                 0
#define SysTick_RVR_RELOAD(x)                    (((uint32_t)(((uint32_t)(x))<<SysTick_RVR_RELOAD_SHIFT))&SysTick_RVR_RELOAD_MASK)
/* CVR Bit Fields */
#define SysTick_CVR_CURRENT_MASK                 0xFFFFFFu
#define SysTick_CVR_CURRENT_SHIFT                0
#define SysTick_CVR_CURRENT(x)                   (((uint32_t)(((uint32_t)(x))<<SysTick_CVR_CURRENT_SHIFT))&SysTick_CVR_CURRENT_MASK)
/* CALIB Bit Fields */
#define SysTick_CALIB_TENMS_MASK                 0xFFFFFFu
#define SysTick_CALIB_TENMS_SHIFT                0
#define SysTick_CALIB_TENMS(x)                   (((uint32_t)(((uint32_t)(x))<<SysTick_CALIB_TENMS_SHIFT))&SysTick_CALIB_TENMS_MASK)
#define SysTick_CALIB_SKEW_MASK                  0x40000000u
#define SysTick_CALIB_SKEW_SHIFT                 30
#define SysTick_CALIB_NOREF_MASK                 0x80000000u
#define SysTick_CALIB_NOREF_SHIFT                31

/**
 * @}
 */ /* end of group SysTick_Register_Masks */


/* SysTick - Peripheral instance base addresses */
/** Peripheral SysTick base pointer */
#define SysTick_BASE_PTR                         ((SysTick_MemMapPtr)0xE000E010u)
/** Array initializer of SysTick peripheral base pointers */
#define SysTick_BASE_PTRS                        { SysTick_BASE_PTR }

/* ----------------------------------------------------------------------------
   -- SysTick - Register accessor macros
   ---------------------------------------------------------------------------- */

/**
 * @addtogroup SysTick_Register_Accessor_Macros SysTick - Register accessor macros
 * @{
 */


/* SysTick - Register instance definitions */
/* SysTick */
#define SYST_CSR                                 SysTick_CSR_REG(SysTick_BASE_PTR)
#define SYST_RVR                                 SysTick_RVR_REG(SysTick_BASE_PTR)
#define SYST_CVR                                 SysTick_CVR_REG(SysTick_BASE_PTR)
#define SYST_CALIB                               SysTick_CALIB_REG(SysTick_BASE_PTR)


#endif
