david20120720/motoko_after_math_linefollower/src/2.1.0/device/stm32f30x/lib_low_level/pwm/drv8834.h

#ifndef _DRV8834_H_
#define _DRV8834_H_

#include "pwm.h"

#ifdef __cplusplus
extern "C" {
#endif

#define SPEED_MAX	((i32)100)

void drv8834_init();
void drv8834_run(i32 left_pwm, i32 right_pwm);

#ifdef __cplusplus
}
#endif

#endif
