david20120720/motoko_after_math_linefollower/src/2.1.0/lib_usr/wifi/wifi_config.h

#ifndef _WIFI_CONFIG_H_
#define _WIFI_CONFIG_H_

#define ESP8266_WIFI_SSID   "disconnected"
#define ESP8266_WIFI_PASS   "veryhard"


//#define WIFI_SERVER_IP        "192.168.2.2"
#define WIFI_SERVER_IP        "192.168.2.10"
#define WIFI_TERMINAL_PORT    2010
#define WIFI_COMMON_PORT      2001


#endif
