david20120720/motoko_after_math_linefollower/src/2.1.0/device/stm32f30x/lib_low_level/int_def.h

#ifndef _INT_DEF_H_
#define _INT_DEF_H_

#ifndef u32
typedef unsigned int u32 ;
#endif

#ifndef u16
typedef unsigned short int u16 ;
#endif

#ifndef u8
typedef unsigned char u8 ;
#endif

#ifndef i32
typedef signed int i32 ;
#endif

#ifndef i16
typedef signed short int i16 ;
#endif

#ifndef i8
typedef signed char i8 ;
#endif

#ifndef mint
typedef float mint ;
#endif

/*
#ifndef uint32_t
typedef u32 uint32_t ;
#endif

#ifndef uint16_t
typedef u16 uint16_t ;
#endif

#ifndef uint8_t
typedef u8 uint8_t ;
#endif


#ifndef int32_t
typedef i32 int32_t ;
#endif

#ifndef int16_t
typedef i16 int16_t ;
#endif

#ifndef int8_t
typedef i8 int8_t ;
#endif
*/


#define false 	0
#define true 	(!false)

#endif
