david20120720/motoko_after_math_linefollower/src/2.1.0/options.h

#ifndef _OPTIONS_H_
#define _OPTIONS_H_

#define __OS_VERSION__			"2.0.6"

#define THREADS_MAX_COUNT  (1 + 5)

#define SCHED_PRIORITY		1

#define OS_WELCOME_MESSAGE	"\nwelcome to SuzuhaOS ^_^ " __OS_VERSION__ "\nBUILD " __DATE__ " " __TIME__ "\n"

/*
#ifndef __FPU_USED
#define __FPU_USED  1
#endif

#ifndef __FPU_PRESENT
#define __FPU_PRESENT  1
#endif
*/

#endif
