david20120720/motoko_after_math_linefollower/(commit log)

2015-04-26 initial release
    [camera.brd, camera.sch, main.brd, main.sch, sensor.brd, sensor.sch]
2015-05-23 new hardware - camera controlled from main mcu
    [camera.brd, camera.sch, main.brd, main.sch, sensor.brd, sensor.sch]
2015-05-30 common commit
    [main.brd, main.sch, sensor.brd, sensor.sch]
2015-12-19 new board
    [camera.brd, camera.sch, main.brd, main.sch, sensor.brd, sensor.sch]
2016-01-18 sources clean up
    [main.brd, main.sch, sensor.brd, sensor.sch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]
2016-01-28 camera driver added
2016-02-08 mess clean up
    [main.drills.xln]
2016-03-14 untold truth burn up
    [line_sensor.c, line_sensor.h, main.asm, robot_config.h, test.c, usr_main.c]
2016-03-29 camera added
2016-04-09 line sensor
2016-04-16 work on new board
    [main.brd, main.sch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]
2016-04-27 debug app added
    [main.brd]
2016-05-12 new hw
    [main.brd, main.sch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]
2016-06-08 encoders added
2016-12-09 board rev 3
    [main.brd, main.sch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]
